lin06121/DCDC_constant_current_power_supply/工程实践与科技创新III-A_第22组李昱林简报.docx

工程实践与科技创新III-A

第_ 22_组工作情况简报

第5周周报

汇报人：李昱林

汇报日期：2026.10.18

# 具体内容：第一周硬件工作 一、本周工作概述本周围绕阻容元件功能通路的设计与测试硬件实验开展全流程工作，完成芯片手册研读、电路参数设计、贴装元件焊接基础练习，以及开关电源核心振荡与PWM调制模块调试，掌握器件选型计算、基础焊接操作与数字示波器高阶使用方法，验证了开关电源PWM占空比自动调节的核心工作原理。

# 二、主要工作内容与成果

### （一）实验预习与电路参数设计

查阅TPS40200芯片数据手册与表面贴装元件规范，完成开关电源核心参数方案设计。掌握芯片基础特性、阻容元件封装与标识规则，明确贴装焊接的工艺参数要求；完成开关频率、软启动时间、输出电压设点、限流保护、滤波网络等关键项的器件选型，确定设计方案。

### （二）元件焊装见习

完成表面贴装阻容元件的焊接基础训练，初步掌握小封装元件对位、上锡、焊点修整技巧，焊点质量符合工艺要求，为完整电路焊装建立工艺基础。

### （三）核心模块调试与测试

分模块开展振荡电路、PWM输出电路功能验证。测试验证了示波器探头阻抗对高频测量的负载效应，总结了输入电压对振荡波形的影响规律；验证了栅极连接状态对PWM波形质量的影响；通过外部注入信号模拟反馈，验证PWM占空比自动调节逻辑。

软件内容 基于 TM4C1294 重构 ADC Demo：以 Timer0A 1 kHz 硬件触发 ADC0 序列并启用 16× 硬件过采样（等效 16 kHz 原始采样率），单序列同步采集 CH0/PE3、CH1/PE2、CH2/PE1 三路信号，保证通道间时间对齐；在采样中断中实现 16 点滑动窗口平均（环形缓冲 + 运行和，O(1) 更新）抑制纹波；SysTick 20 ms 驱动 TM1638 显示、100 ms 刷新电压值，新增 RawToMilliVolts() 整数换算并预留标定接口；新增 uart_debug.c/.h 串口调试模块，UART0 @115200 每 100 ms 输出三路电压与原始码值，提供 Init/String/Line/ADCDump 四个 TX-only 接口，并完成 Keil 工程注册。

第6周周报

汇报人：李昱林

汇报日期：2026/10/25

这周在硬件实验二及第二阶段稳流源电路的 PCB 设计与调试过程中，我们重点围绕 TPS40200 降压/稳流转换器的核心参数、故障排查以及 PCB 布局规范进行了系统性梳理。以下是主要问题与解决方案的总结：

一、 硬件实验二：TPS40200 降压稳压模块调试与问题解决

1. 开关频率 ( f_(SW) ) 的核算与确认
  - 问题：需要确保振荡参数与开关频率的匹配性。
  - 解决方案：根据外接振荡元件参数（如 R_7 =300 kΩ 、 C_9 =1500 pF ），通过标准公式计算并确认系统的标称开关频率设定在 300 kHz 。同时核对了限流滤波电容 C_12 的理论计算边界。
2. 误触发过流保护（OCP）的排查
  - 问题：电路在运行或加载时频繁出现无规律的提前过流保护关断。
  - 解决方案：经排查确认核心原因是 C_11 （VDD 旁路去耦电容）容量偏小。当高侧 MOSFET 导通时引起 VDD 电压瞬时塌陷和高频毛刺，干扰了 ISNS 与 VDD 的过流比较基准。增大并优化 C_11 后成功消除了误触发。
3. 纹波与转换效率的指标优化
  - 现状与方向：当前实测输出纹波约为 60 mV ，转换效率约为 85% 。
  - 解决方案：明确了后续通过选用更低 ESR 的输出电容、降低电感 DCR 以及合理匹配假负载（如静态维持用的 R_23 =200 Ω 降压轻载电阻或满载功率电阻）来进一步压缩纹波和提升效率的路径。

二、 阶段二：稳流源电路 PCB 画板与系统设计

1. 模块功能定位与指标
  - 设计要求：基于 TPS40200 构建直流稳流（Constant Current）模块，主要实现 0.1–1.0 A 可调电流输出 以及 5.25 V 限压保护。
2. PCB 独立构建与系统交互
  - 布局规划：该模块作为独立构建的自定义 PCB（不包含在 MCU 载板 A2000TM4 上），需要与主控 MCU 进行紧密交互。
  - 关键设计要点：
    - 需通过 I²C 接口的 DAC6571 接收外部指令进行电流设定。
    - 需通过 ADC 实时监测输出电压与电流。
    - 在 PCB 画板布线时，必须严格做好功率开关回路（大电流、高频开关节点）与弱电数字通信信号（I²C / ADC 采样线）的地线隔离与去耦，防止高频开关噪声耦合至控制端。

第7周周报 汇报人： 汇报日期： | 具体内容：
第8周周报 汇报人： 汇报日期： | 具体内容：
第9周周报 汇报人： 汇报日期： | 具体内容：
第10周周报 汇报人： 汇报日期： | 具体内容：
第11周周报 汇报人： 汇报日期： | 具体内容：
第12周周报 汇报人： 汇报日期： | 具体内容：
第13周周报 汇报人： 汇报日期： | 具体内容：
第14周周报 汇报人： 汇报日期： | 具体内容：
