lin06121/DCDC_constant_current_power_supply/Pastcode/工程实践与科技创新[3A]-第33组(于前程)设计报告(1).docx

| 班级 | 学号 | 具体负责的工作 | 联系方式
于前程 | F1703401 | 517030910121 | 实验安排，电路设计，电路调试，报告撰写 | 19821244293
韦金星 | F1703401 | 517030910165 | 电路焊装，电路调试，报告撰写 | 15201951656
宋许健 | | | 程序设计，电路调试，报告撰写

摘 要：

本报告为 2019级工程实践与科技创新 3A 第 33组的实验报告，本报告主要介绍了基于 TPS40200 芯片DC-DC 开关电源电路的设计，介绍了单片机MSP430对电源进行监控和均流控制的实现过程。系统可并联输出电压和电流，控制输出电流大小，显示当前输出电压和电流，带输出保护和负载均衡。总体输出表现为稳压电源，直流电压5V，输出额定电流达到2A。

报告从设计思路、电路设计、硬件的工作原理、电路参数的选取、焊接过程、程序设计以及调试结果进行介绍，包含有 MSP430 单片机程序各个模块的功能、系统框图、硬件和软件的实现方法以及最终成果照片。附录为我们小组实验过程中遇到的问题、实验心得以及程序清单。

关键词：

DC-DC开关电源， MSP430单片机，TPS40200，A/D转换，负载均衡

ABSTRACT

This report is the experiment report of the 33rd group of engineering practice and scientific and technological innovation 3a in 2019. This report mainly introduces the design of DC-DC switching power supply circuit based on tps40200 chip, and introduces the realization process of power supply monitoring and current sharing control by MSP430 single chip microcomputer. The system can parallel output voltage and current, control output current, display current output voltage and current, with output protection and load balancing. The overall output is a regulated power supply with a DC voltage of 5V and a rated output current of 2A.

The report introduces the design idea, circuit design, working principle of hardware, selection of circuit parameters, welding process, program design and debugging results, including the function of each module of MSP430 single chip computer program, system block diagram, realization method of hardware and software and photos of the final results. The appendix shows the problems, experience and program list of our group in the process of experiment.

KEYWORDS

DC-DC switching power supply, MSP430 single chip microcomputer, tps40200, A/ D conversion, load balancing

目 录

2.2.3 单片机控制模块...........................................................................................4

3.5 关键问题与解决方案.......................................................................................11

# 1. 概述

## 1.1 编写说明

本报告为2019~2020学年上海交通大学电子系工程实践与科技创新3A第33小组的课程设计报告。本报告详细介绍了基于开关稳压稳流并联电源的硬件电路设计，单片机软件开发流程，程序设计思想，测试方法，测试指标与结果以及实验中遇到的各种问题和解决方法。分别介绍了稳压源、稳流源及并联系统的设计与实现过程。同时也表达了我们实验的心得体会，以供后续的实验者参考。

本报告的适读对象为选修 3A 课程的学生及电子电路相关专业人士以及有一定基础的业余电子设计爱好者。编写过程中错误疏漏在所难免，希望各位读者批评指正。

## 1.2 名词定义

开关式稳压电源：采用开关三极管控制的直流稳压电源，可通过占空比的调节控制电压输出。（本实验中使用TL2371输出的PWM波控制开关占空比。）

降压型DC-DC开关电源：通过芯片控制实现高电流电输入转化为低电流电输出的系统。（直流到直流的降压变换。）

均流控制：双并联的电路在稳压输出的情况下调整电流输出，使得各个电源的输出电流相等。

纹波：纹波是由于直流稳定电源的电压波动而造成的一种现象，因为直流稳定电源一般是由交流电源经整流稳压等环节而形成的，这就不可避免地在直流稳定量中多少带有一些交流成份，这种叠加在直流稳定量上的交流分量就称之为纹波。

PWM 信号：脉冲宽度调制信号。脉冲信号的占空比受到调制的一种信号。

占空比：在一串理想的脉冲序列中，正脉冲的持续时间与脉冲周期的比值。
开环控制[1]：控制装置与被控对象之间只有顺向作用而没有反向联系的控制。
闭环控制[2]：对系统的输出进行测量，并将它反馈至输入端与输入（预期的输出）进行比较（相减），利用其误差信号对系统进行控制。
数模转换[3]：为把数字信号转换为信息基本相同的模拟信号而设计的处理过程。
模数转换[4]：为把模拟信号转换为信息基本相同的数字信号而设计的处理过程。
开关频率：开关电源中，开关管导通，关闭的频率。
电压调整率[5]:用来描述输入电源电压的变化导致的开关稳压源输出电压发生的微小变化的指标。
负载调整率[5]:用以衡量负载改变时开关稳压源输出电压的变化的指标。
负载均衡度：用以描述供电系统电流均流的程度的指标。

脉冲宽度调制：一种对模拟信号电平进行数字编码的方法。通过高分辨率计数器的使用，方波的占空比被调制用来对一个具体模拟信号的电平进行编码。

## 1.3 硬件开发环境

开发工具 | 功能 | 工作环境
直流稳压源 | 提供10~20V稳定输入电源 | 220V交流电
万用表 | 测量电压、电容、电阻数值 | 220V交流电
示波器 | 测量纹波 | 220V交流电
电烙铁，焊锡，镊子，钳子 | 焊接电路 | 220V交流电/实验台

表1 硬件开发环境

## 1.4 软件开发环境

开发工具 | 功能说明 | 运行环境
CCS(Code Composer Studio) | 单片机集成开发 | Window 10

## 表2 软件开发环境

## 1.5 缩略语

DC： direct current 直流
PWM： Pulse-Width Modulation 脉宽宽度调制
ADC： analog digital convert 模拟-数字转换

DAC： digital analog convert 数字-模拟转换

CCS ： code composer studio 一种集成开发环境

LPF ： low-pass filter 低通滤波器

# 2. 系统总述

## 2.1 系统组成[6]

基于TPS40200的

DC-DC开关稳压电源

+

−

10-20V

io1

负载

电流检测

+

−

5V

基于TPS40200的

DC-DC开关稳流电源

电流检测

+

−

电流设点

io2

控制部件

ADC1

电流测量

ADC3

电压测量

MSP430

单片机系统

DAC6571

I2C

ADC2

电流测量

图 1 系统总框图

系统总框图如上，需要搭建一个稳压电源模块、稳流电源模块并联输出，单片机实施均流控制的并联供电系统。总体输出表现为稳压电源，直流电压5V，输出额定电流达到2A。

## 2.2 系统的主要功能

DC-DC开关稳压源输入电压10-20V，输出电压5V，额定电流1A，有过流保护；在稳压源基础上改装DC-DC开关稳流源，输出电流0.1-1A，带过流保护和限压保护，使用MSP430单片机编程控制DAC6571，设置输出电流；稳压源模块和稳流源模块分别可以独立工作。当这两个模块联合后并联输出，整体成为一个稳压电源系统，可以提供更大的输出功率。并联工作时，稳压源模块作为主（控制）模块，稳流源模块作为从（受控）模块，输出电流跟随主模块输出电流的变化而变化，利用单片机检测两路输出电流，均衡后输出。

### 2.2.1 DC-DC 开关稳压电源模块

#### 2.2.1.1 稳压输出

DC-DC 开关式稳压电源模块基于TPS40200，可适配直流输入电压10-20V ，输出端在不同负载的情况下（包括空载）直流输出电压稳定在为5V 左右。同时具有较高电源转换效率和较小输出纹波。

#### 2.2.1.2过流保护

为了避免电路中的较大电流会对电路元器件造成损伤，电路设有过流保护功。当输出电流大于设定的阈值时，电路自动关断，输出电流和输出电压均为0。

#### 2.2.1.3电压电流监测

电流采样传感信号通过差分放大电路模块检测电流，电压值，并将其显示在单片机上。

### 2.2.2 DC-DC 开关稳流电源模块

#### 2.2.2.1稳流输出

DC-DC开关式稳流电源模块基于TPS40200，可适配直流输入电压10-20V，其直流输出电流稳定在一个设定值，该设定值可在指定范围内选择设置。

#### 2.2.2.2 限压保护

为了避免接较大负载或者空载时，电路中的大电压对电路元器件造成损伤，电路增加了限压保护功能。当输出电压大于设定的阈值时，电路将自动调整输出电压到正常的值。

#### 2.2.2.3 电压电流监测

电流采样传感信号通过差分放大电路模块检测电流，电压值，并将其显示在单片机上。

2.2.3单片机MSP430小系统精密均流调整模块

该模块在稳压源和稳流源并联工作时使用，使用MSP430 单片机控制 DC-DC 开关电源均流。单片机通过内置 ADC 监测两路电源模块的输出电流，利用DAC芯片 DAC7611 输出控制信号，控制稳流源输出电流。单片机调用上述 ADC 及 DAC，并使用控制算法构建出完整测控系统，最终实现控制电流源的输出电流，使得并联系统稳压源稳流源电流相等，即实现稳压源与稳流源的负载均衡的功能。

# 3. DC-DC开关稳压电源模块的设计和实现

## 3.1 主要功能与设计指标

### 3.1.1 主要功能

该模块的核心器件是TPS40200，能在直流输入电压10-20V 下稳定输出直流电压5V 。模块内部包含输出电流采样传感部件，可以完成限流保护功能。该模块要兼顾负载调整率、电压调整率、电源转换效率与输出电压纹波幅度，同时通过单片机和放大采样电路实现输出电压和输出电流的监控和显示功能。

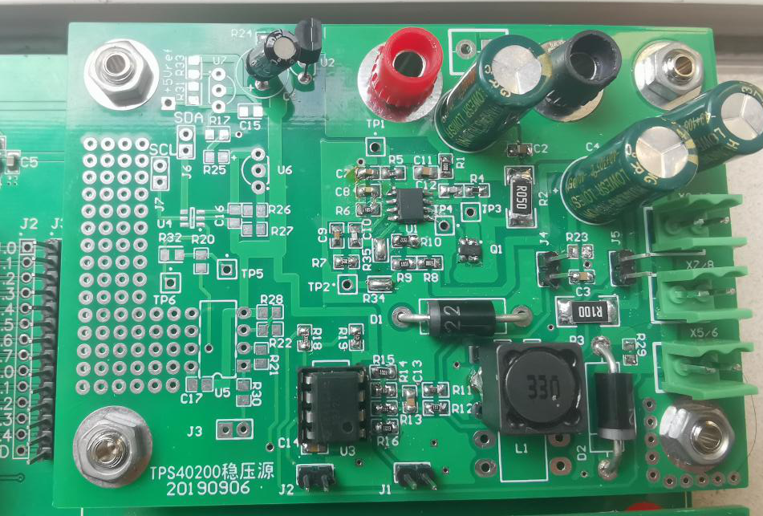
[picture p1: figure]

图2 DC-DC开关稳压电源模块焊接成品

### 3.1.2 设计指标

具体设计指标及最终参数选择如下表所示。

设计要求 | 设计指标 | 元件参数
外围RC定时电路 | 振荡频率取300KHz左右 | R5 = 68kΩ C7 = 470pF
设置软启动定时 | 不小于50ms | C8 = 10 uF
设置输出电压 | 按要求5V | R10 = 16kΩ
设置过流保护 | 输出过流保护触发值允许范围： 1.1A~1.9A | R4 = 2k C12 = 200pF
输出电流检测信号 | 放大10倍 | R15=R16=100kΩ R13=R14=10kΩ
输出电压信号调理 | 二分之一衰减 | R18=R19=10KΩ

表3 DC-DC开关稳压电源模块设计指标[¹]

## 3.2 电路设计原理

### 3.2.1 核心器件TPS40200

TPS40200为宽输入非同步降压DC/DC控制器芯片，TPS40200的原理图[7]如下所示：

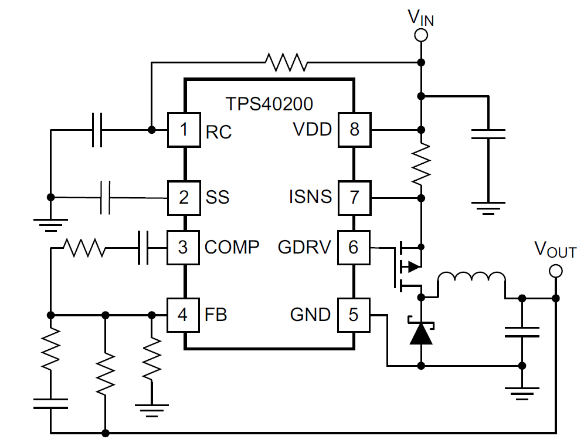
[picture p2: figure]

图3 TPS40200原理图

TPS40200功能框图[7]如下所示：

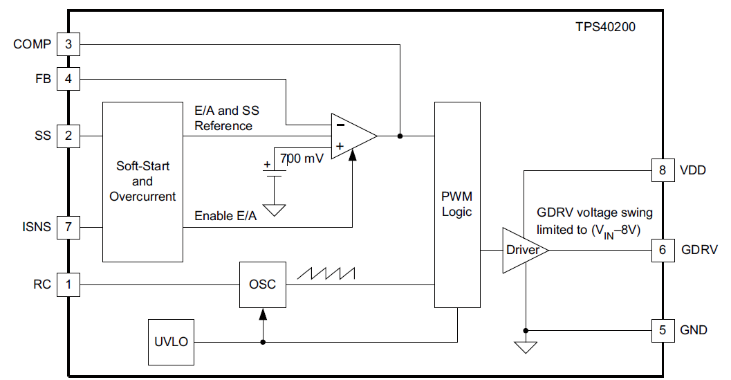
[picture p3: figure]

图4 TPS40200芯片结构图

芯片管脚和对应功能[7]：

输入电压和欠压保护 UVLO（8号脚） 一般工作在4.5V以上电压，输入电压范围4.5V–52V。大于UVLO门限4.25V 以上就可工作。当大于 UVLO 门限时，芯片启动，转换开始，软启动电路使能。TPS40200将以接在软启动引脚（SS）上的外部电容（软启动电容）决定的速率提高输出电压。欠压保护机制可以确保仅当输入电源电压已经超过正常工作所需最小电压时，芯片才正确启动。

软启动（2号脚） 软启动作用于变换器控制电路，通过逐渐增加脉冲占空比实现。通过软启动控制电路，可以使变换器从零启动，减小电流浪涌带来的浪涌电流应力，提升系统的稳定性。同时，在过流保护情况下会根据软启动定时进行打嗝重启（反复重启），在检测到过流条件消失后恢复系统的输出。

PWM信号输出与输出电压（6号/4号脚）GDRV脚（6号管脚）会输出脉宽调制PWM信号，该信号控制开关管的连通和关断，以此来控制输出电压的高低。而输出电压通过反馈电路经过分压反馈给FB脚（4号管脚），与内部基准电压696mV通过误差放大电路进行比较，对PWM进行调控，调整输出电压。具体调节的方式如图4所示。通过这一反馈调节，可以形成动态平衡，最终使输出电压稳定某一设定值。

锯齿波生成（1号脚）：通过外部连接一个RC电路，可以设置TPS40200的工作频率。外部的RC电路与TPS40200内部的电路形成一个锯齿波生成电路，TPS40200将以此频率生成锯齿波，该锯齿波可以在RC脚（1号管脚）检测到。

过流保护（7号/8号脚）：检测VDD脚（8号管脚）与ISNS脚（7号管脚）的压降，若存在100mV以上压降，则达成过流条件，输出的PWM波持续处于高电平，使开关管关断，使输出电压降为0V，保护电路和负载

### 3.2.2设计原理

本模块电路分为以下几个模块构成：外围RC定时电路部分、软启动定时部分、电压控制部分、电压输出部分、过流保护部分、辅助电源部分、电压电流检测部分。

大部分元件参数在电路图中已经给出，少部分元件的参数需要通过自己的计算推导进行设计。整体电路图[8]如下图所示：

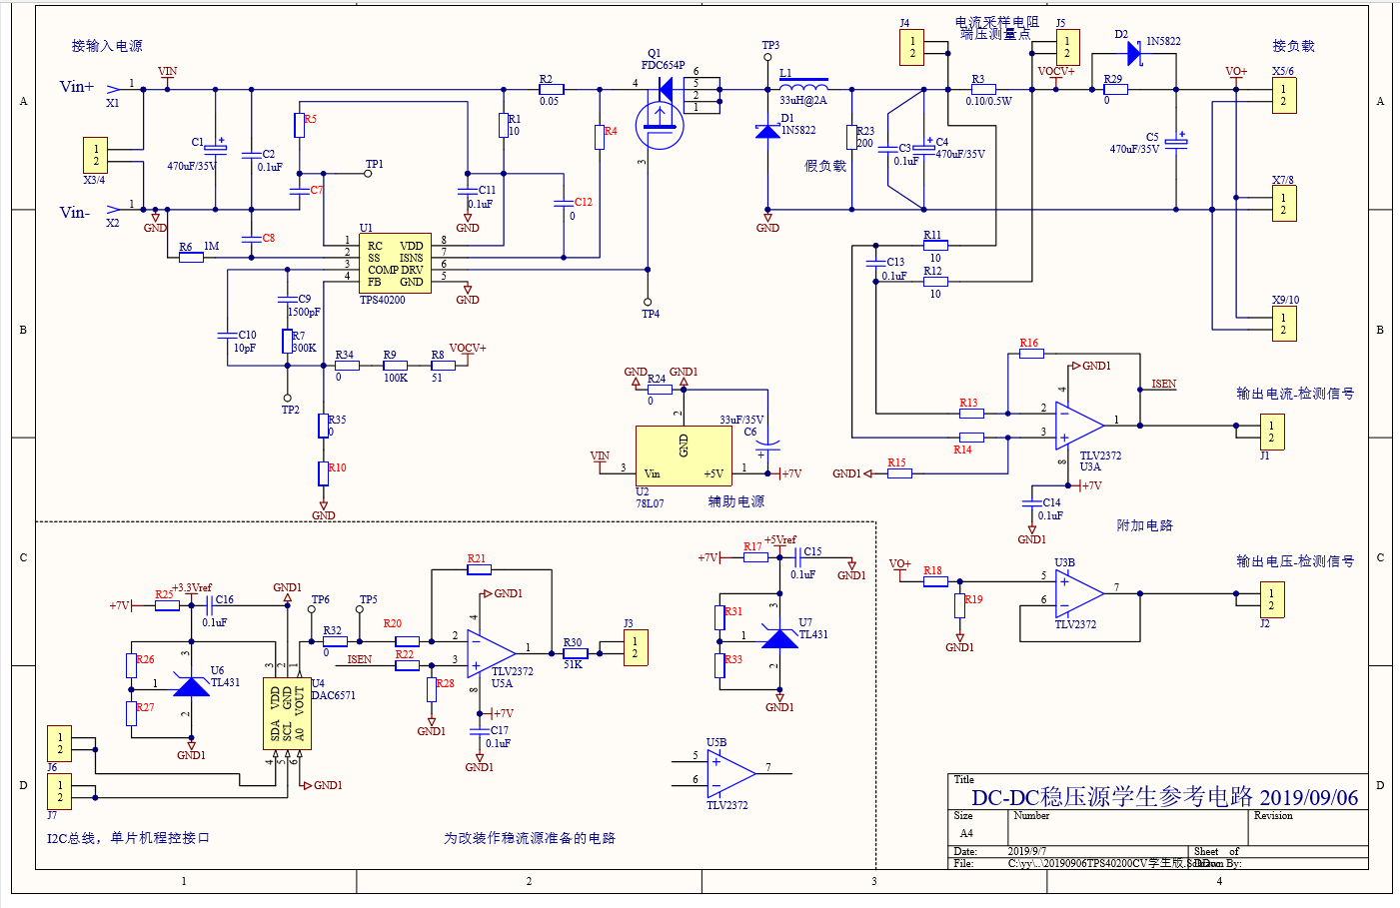
[picture p4: figure]
捕获

图5 DC-DC开关稳压电源模块电路图

## 3.3 电路各部分设计与元件参数说明

### 3.3.1 外围RC定时电路部分设计

本模块中TPS40200工作频率是由和控制。振荡器频率计算公式如公式(1)所示，振荡频率按要求取300kHz。同时，应足够大，使得通过的电流不超过750μA，如公式(2)所示。

(1)

（2）

所以最终选取以及，此时。

经过调试，该参数能使TPS40200工作正常。

### 3.3.2 软启动定时部分设计

上面的介绍中已经知道本模块中软启动定时的设定由控制。根据芯片手册中的公式(3)，由于软启动定时，且、、，代入可得到结果。

(3)

所以我们选取了10μF的电容，经过调试，该参数能使TPS40200工作正常。

### 3.3.3 输出电压部分设计

输出电压的设定涉及到电压反馈，主要由由、和组成。这三个电阻组成了一个分压电路，由于TPS40200的FB脚（4号管脚）在稳态是恒定的696mV，且输出VOCV+是所设定的5.00V，根据公式(4)，R2=（100K+51）Ω，可以得到。

（4）

经过调试，取时，输出电压满足相应的指标要求。

### 3.3.4 过流保护部分设计

过流检测阈值由元件R4，C12决定，要求输出过流保护触发值允许范围为1.1A~1.9A

相关的电路原理图[7]如下所示：

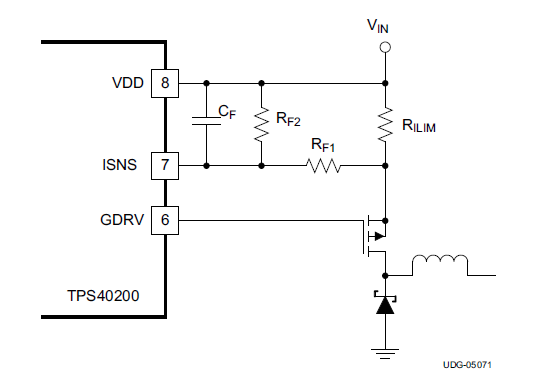
[picture p5: figure]

图 6 过流保护检测模块

参照软件手册计算得R4=2kΩ，C12<400pF，取200pF。经电路调试后发现选择该参数可以实现过流保护。

### 3.3.5 电压电流检测部分设计

### 本模块中，、、和与运算放大器TLV2372构成一个差分放大电路，用以监测输出电流。我们可以通过测量的电流采样电阻的电压来获得实际输出电流。考虑到单片机ADC的精度和电压承受范围以及TLV2372的驱动电压，我们采用10倍放大对电流采样电阻两端的电压进行放大。根据公式(5)，选取R13 = R14 = 10kΩ，R15 = R16 = 100kΩ。

（5）

和与运算放大器TLV2372构成一个电压跟随器，用以监测输出电压。考虑到单片机ADC的精度和电压承受范围以及TLV2372的驱动电压，我们将输出电压分压成一半。即选取R18 = R19 = 10kΩ。

经实体电路测试，上述取值均符合设计指标。

## 3.4 输出电压与输出电流监测的实现

本模块中输出电压与输出电流的检测由单片机内部ADC10模块来实现。可将硬件电路部分的监测点用杜邦线连接到单片机引脚上，在第一阶段中，用于测量电流的J1连接单片机P1.0引脚，用于测量电压的J2连接单片机P1.1引脚。ADC采用单通道单次采样，其模式设置可参考msp430x2xxx family 单片机 user guide.pdf。系统实现的流程图如下：

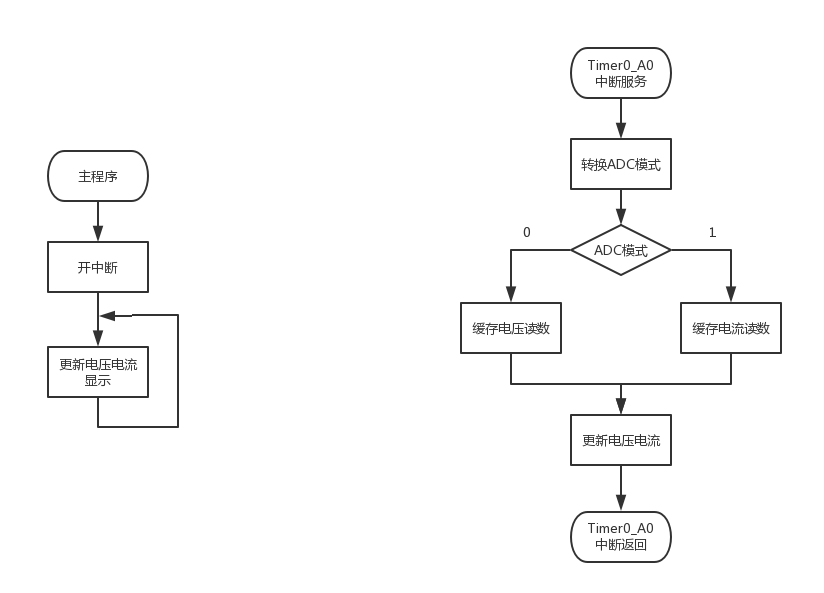
[picture p6: figure]

图 7 单片机代码实现流程图[9]

为了消除随机电噪声带来的读数波动，可对多次采样的结果取平均值。实际调试结果表明当取上千次平均时测量值可以保持很稳定。受制于单片机的内存大小，无法把全部数据都储存在数组中，因此我们在第一阶段使用单通道时分切换采样两路电信号，将电压电流信号采样数据缓存在两个较大的数组中，每采样一次就对缓冲区的所有点做平均求出此刻的电压电流量，这样做虽然消耗空间很大，但是非常灵敏，已经满足本阶段的要求。

得到ADC多次采样的结果，再乘以相应系数，即可得到对电压或电流量的初步估计，但是此时很可能误差不满足指标。为了提高测量精度，可设置一个线性公式拟合消除可能的偏差。其基本思想是，测出若干组实测值X（电流采样电阻端压或负载端压）和显示值Y（单片机示数），拟合出一个线性关系 Y = kX+b，对原系数进行修正，即可得使得显示值得比较接近实测值。拟合的过程将在5.4.2节举例阐述。

## 3.5 关键问题与解决方案

### 3.5.1纹波调整[5]

输出电压纹波主要有两个来源：

（1） 开关交替充放电因素，波形成分表现为三角波形，如下图中的蓝色部分。
（2） 开关切换瞬间的电磁涡流感应因素，波形成分表现为尖刺波形，如下图中的橙色部分。

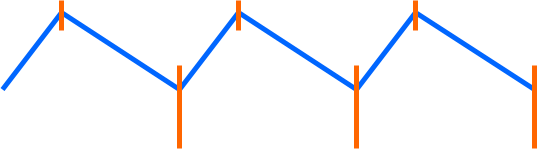
[picture p7: figure]

图 8 输出电压纹波示意图[5]

我们小组一开始测量纹波的时候波形很不稳定，峰峰值时大时小。后来发现是示波器探头与电路接触不好导致的，后来更换示波器探头使之与导线完全接触，这样波形就能够稳定下来。调试电路时得到的纹波较小，符合标准，我们小组就没有对电路进行改进。

### 3.5.1 效率调整[5]

可以通过增大假负载来提高电源效率。该措施可以减小空载时假负载上的电流，可以一定程度上提高效率，开始时转换效率只有86%左右，这个是比较低的，所以我们小组最后拆去了假负载，最后几次调试电路时电压转换效率基本在90%左右，虽然这么做对纹波有一定的影响，但还好影响不大。

### 3.5.2 单片机显示精度调整[1][10]

单片机显示精度的调整通常有四个措施：

（1） 做好ADC前置调理电路的性能，即精选电阻，减小前置差分放大电路元件值实际误差
（2） 通过软件逻辑设计补偿显示误差，即使用线性公式或使用查表法对显示结果进行精调
（3） 通过软件滑动窗口平均算法增加显示数值稳定性，单片机软件设计上增加抗噪声措施，即多次采样取平均，相当于低通滤波的效果，减小瞬时随机噪声影响
（4） 软件逻辑中使用阻滞门限增加显示数值稳定性

# 4. DC-DC开关稳流电源模块的设计和实现

## 4.1 主要功能和设计指标

### 4.1.1 主要功能

DC-DC开关稳流电源模块在DC-DC稳压源模块的基础上进行改进，在实现单片机检测输出电压和电流的情况下，还能设定电流源输出电流值，主要功能如下：

（1） 实现稳流源的限压在5V左右
（2） 单片机指定稳流源输出电流值
（3） 单片机监测稳流源输出电压和电流值
（4） 在输入电压为10±0.1V和负载电阻合理的情况下，输出指定电流，输出电压和负载值呈 线性关系，若负载不符合条件则将触发限压保护。

### 4.1.2 设计指标

检测项目 | 检测条件 | 检测指标
输出电流绝对精度 | 输入10.0V±0.1V； 设定输出电流0.1、0.2或0.3A Rload=5.1Ω或10Ω | 围绕精确数值±0.5mV以内波动
| 输入10.0V±0.1V； 设定输出电流0.8A Rload=3Ω或5.1Ω | 78.0~82.0mV波动
输出限压保护和恢复 | 输入电压10.0V±0.1V；设定输出电流1.0A | 限压输出5.0~5.4V，且更换负载电阻后输出电流恢复正常。
单片机监测电压和电流 | 输入10.0V±0.1V；任选一种输出≥0.5A的工作状态进行检测 | 输出电压误差小于等于0.02V
| | 输出电流误差小于等于0.01A

表 4 DC-DC开关稳流电源设计指标[11]

## 4.2 电路原理

### 4.2.1 电路整体原理

DC-DC 开关稳流源的整体电路设计基于DC-DC开关稳压源的设计原理图改造而来，大部分与稳压源设计类似，在此不多做阐述，仅描述稳流功能的实现。DC-DC 开关稳流源在稳压源的基础上，添加误差放大电路，确定电流误差后，以DAC6571 为核心控制器件，单片机通过I2C程控DAC6571的输出，作为设定的电流值；该电流值再通过差分放大电路开环控制稳流源电流的实际输出， 稳流源改装方案[12]如下图所示：

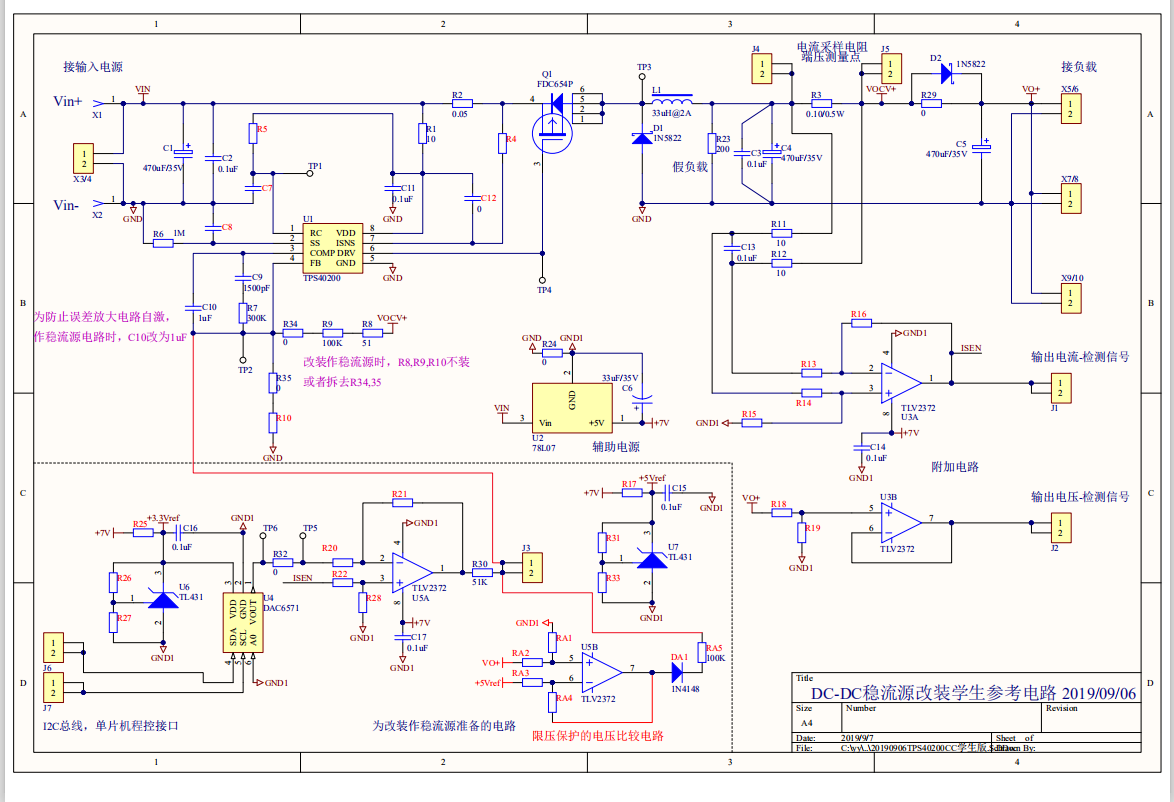
[picture p8: figure]
捕获

图9 稳流源改装参考方案

其具体工作原理如下图所示：

基于TPS40200的

DC-DC开关稳流电源

+

−

10-20V

io2

负载

电流检测

+

−

0.1A~1A

控制部件

ADC1

电流测量

ADC2

电压测量

MSP430

单片机系统

DAC6571

电流设点

I2C

图10 稳流源设计原理[6]

### 4.2.2 误差放大电路

误差放大电路的作用是比较差分放大电路两路信号，确定电流误差。如下图所示，ISEN是对输出电流做检测得到的信号，TP5是对输出电流设点的控制信号，选取,则差分放大电路的输出为实际电流值 ISEN与设定电流值之差的10倍，即J3 = 10 * (ISEN - TP5)。

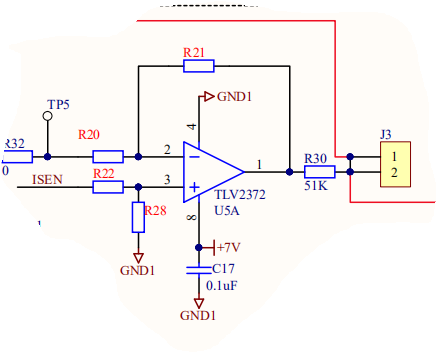
[picture p9: figure]
捕获

图11 误差放大电路[12]

差分放大电路的输出值J3作为TPS40200芯片内部的的差分放大器的输入，与0.696V进行比较。如果J3大于0.696V时，TPS40200的输出电压VO+将减小，因此电路的实际输出电流ISEN将减小，知道J3输出值无限逼近0.696V。这时可认为实际输出电流ISEN与TP5设定电流值大致相等，达到稳流效果。

所以在本次实验中，差分放大器我们选择放大倍数为10倍，最后选定，。

### 4.2.3 DAC6571程控输出电流的控制

DAC6571芯片管脚图和管脚描述分别由下面的图12和表5所示，外围RC电路提供3号管脚所需的+5V输入电压，2号管脚接地，芯片正常工作。

图12 DAC6571芯片管脚图[3]

管脚 | 名称 | 描述
1 | VOUT | DAC输出电压
2 | GND | 接地点
3 | VDD | 输入电压
4 | SDA | 串行数据输入
5 | SCL | 串行时钟输入
6 | A0 | 设备地址选择

表5 芯片管脚描述[3]

下图为单片机控制DAC6571的电路图部分：

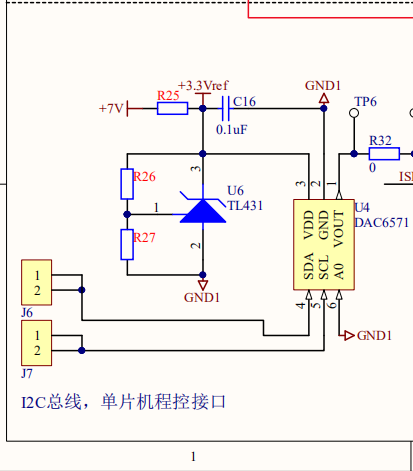
[picture p10: figure]
捕获

图13 单片机控制DAC6571电路图[12]

如上图所示，管脚4的串行数据输入信号和管脚5的串行时钟输入信号作为DAC6571芯片的I2C接口与单片机进行通信。单片机在串行时钟信号的控制下，将电流数据作为串行输入数据输入到DAC6571芯片内部，从而芯片1号管脚输出相应电压，从而产生输出电流。单片机编程控制接口是I2C总线标准的，用GPIO模拟I2C。

由于需要键盘输入来设定输出电流值，从而要在程序代码中设置中断，定时检测键盘输入值，再根据键盘的输入值调整电流值，最后传给芯片。

单片机控制DAC6571芯片的流程图[9]如下图所示：

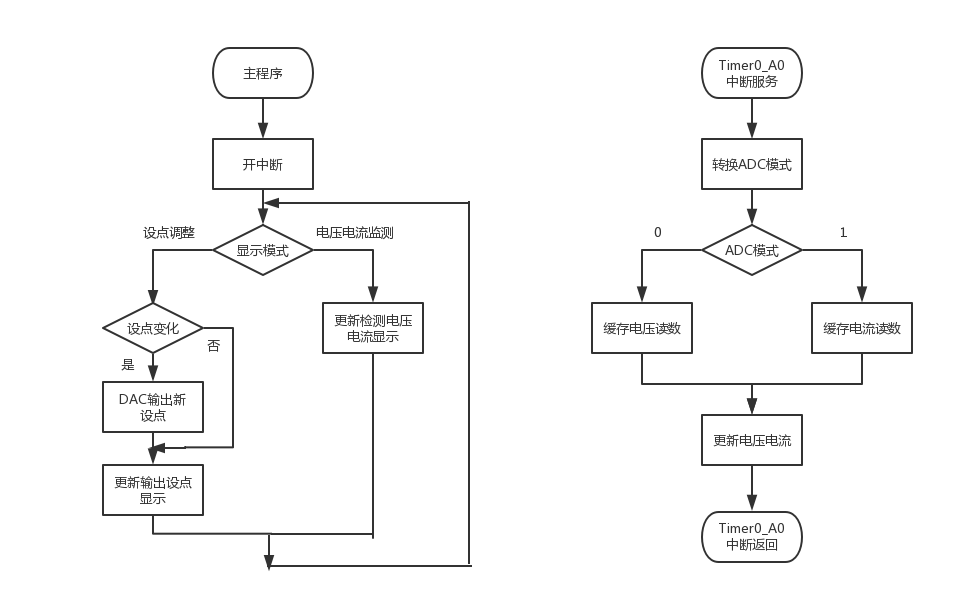
[picture p11: figure]
88642791b83076162f312944fe5e630

图14 单片机稳流电路控制流程图

为了方便测试需要和校对结果，本系统采用了两种步长的电流调整方式，对应按键的具体功能如下表所示：

按键 | 功能
S1 | 电流+0.01A
S2 | 电流-0.01A
S3 | 电流+0.1A
S4 | 电流-0.1A

表6 稳流源模块按键功能描述

DAC6571芯片3号管脚的输入电压VDD运用TL431产生，电路图如下图所示：

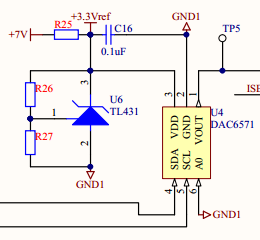
[picture p12: figure]
DAC电压提供

图15 TL431基准电压产生电路图[12]

基准电源电路主要由一个稳压二极管TL431组成。TL431稳定电压计算公式[3]：

V_(out) = (R_26 +R_27)/(R_27)V_(ref)

其中为TL341内部基准电压，为2.5V。为保证输出电压，选取，

由于，规定满足，又为了保证稳压管正常工作，所以选取

### 4.2.4 限压保护电路

电压比较(差分放大)如下图电路所示，其中VO+为输出电压采样。由于二极管DA1的存在，使该部分电路的输出在常态下对ErrAmp无影响；而发生限压作用时，其输出对稳流放大造成压制。当实际输出电压VO+大于5V时，运算放大器U5B的输出为正，从而使二极管DA1导通，从而使得J3的输出增加。与上述稳流原理一致，当J3的输出增加，芯片TPS40200调节输出VO+，VO+减小，直至VO+小于5V，运算放大器U5B输出为负，从而二极管DA1截止，J3输出不受影响。

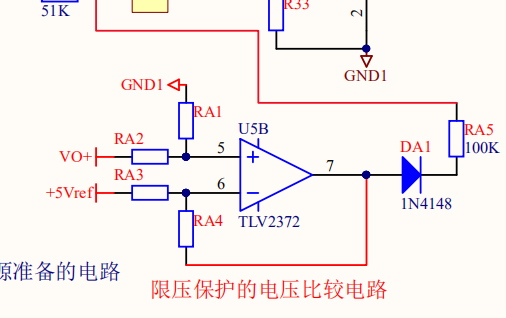
[picture p13: figure]
捕获

图16 限压保护电路[12]

要求差分放大电路放大倍数同样为10倍，所以本次实验中，选定，。

其中提供基准的+5V参考电压运用TL431产生，相关电路图如下所示：

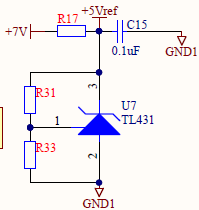
[picture p14: figure]

图 17 TL431基准电压产生电路[12]

基准电源电路主要由一个稳压二极管TL431组成。TL431稳定电压计算公式[3]：

其中为TL341内部基准电压，为2.5V。为保证，选取，为保证稳压管正常工作，选取较小的值，从而选取。

# 5. 双模块并联输出及负载均衡

## 5.1 主要功能与设计指标

### 5.1.1 主要功能

双模块并联输出的主要功能：输入10~20V的直流电压，通过反馈并联输出约5V的直流电压，输出额定电流达到2A，两模块输出电流基本相同。该模块要兼顾负载均衡误差与电压波动。同时通过单片机和采样电路实现输出电压和两模块输出电流的监控功能。

### 5.1.2 设计指标

具体设计指标如下表所示。

检测项目 | 检测条件 | 数值要求
负载均衡度 | 输入10.0V±0.1V； Rload=5.1Ω//10Ω | 并联输出电压须稳定在4.85~5.15V，负载均衡误差小于等于2%，且两路电阻端压各自波动均小于等于2mV
| 不下电更换 Rload=5.1Ω//5.1Ω | 并联输出电压须稳定在4.85~5.15V，负载均衡误差小于等于2%，且两路电阻端压各自波动均小于等于2mV，
单片机监测电压和电流 | 输入10.0V±0.1V；（输出总电流大于0.8A）进行检测 | 误差小于等于0.02V，
| | 误差小于等于0.01A，
| | 误差小于等于0.01A，

表7 双模块并联输出设计指标[¹¹]

## 5.2 电路设计原理

### 5.2.1 电路结构图[6]

综合前两个阶段的成果，搭建一个稳压电源模块、稳流电源模块并联输出，单片机实施均流控制的并联供电系统。总体输出表现为稳压电源，直流电压5V，输出额定电流达到2A。其相关结构图如下 ：

基于TPS40200的

DC-DC开关稳压电源

+

−

10-20V

io1

负载

电流检测

+

−

5V

基于TPS40200的

DC-DC开关稳流电源

电流检测

+

−

电流设点

io2

控制部件

ADC1

电流测量

ADC3

电压测量

MSP430

单片机系统

DAC6571

I2C

ADC2

电流测量

图18 双模块并联输出结构图[6]

### 5.2.2 电路改装

需要对原来的稳压源电路板进行少许改装：

（1） R29不装，加装D2，二极管防止并联后外部电流倒灌

（2）调整R10取值，即用16的电阻代替原来的15，目的是将输出电压设点抬高至5.3~5.4V，弥补通过上述二极管的压降损失

图19 改装电路示意图[12]

## 5.3信号检测测及程控策略设计

单片机仅能控制稳流电路板的输出电流设点，单片机通过ADC可获得三路检测信号，稳压电路板的输出电流、稳流电路板的输出电流、两者并联输出电压。这些信号均可能存在随机电噪声，需适度做连续多次采样的滑动平均。

每次发出新的控制命令，到检测获知被控系统的有效响应，会有一段ms级时延。控制节奏不能太快，建议取0.05~0.1s一次的控制节奏。控制达成动态均流稳定的过程不能太慢，负载突变后一般要在4秒内达成。开机或负载突变，可能造成稳压电路板发生短时过流自保护，关断输出；若控制策略不当，可能发生“跷跷板”现象，系统无法进入正常工作状态。

整体工作流程如下图所示：

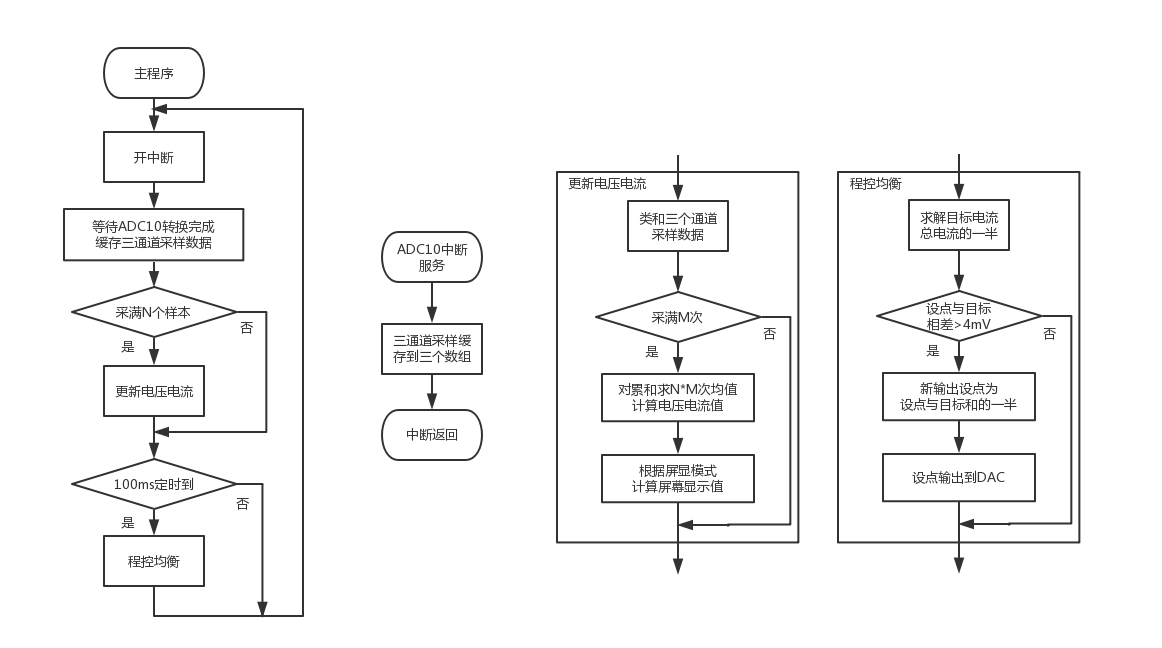
[picture p15: figure]

图20 双模块并联输出程序流程图[9]

### 5.3.1电压与电流监测及显示部分设计

本模块中并联输出电压与两路输出电流的检测由单片机内部ADC10模块来实现。可将硬件电路部分的监测点用杜邦线连接到单片机引脚上，在第三阶段中，用于测量电压的J2连接单片机P1.0引脚，用于测量稳流源电流的J1连接单片机P1.1引脚，用于测量稳压源电流的J1连接单片机P1.2引脚。

为了消除随机电噪声带来的读数波动，可对多次采样的结果取平均值。实际调试结果表明当取上千次平均时测量值可以保持很稳定。受制于单片机的内存大小，无法把全部数据都储存在数组中，因此大概有以下两种解决方案。在第一第二阶段的测量中，我们使用单通道时分切换测量，直接将采样数据缓存在一个较大数组中，每采样一次就对缓冲区的100点做平均求出此刻的电压电流量，这样虽然非常灵敏但是消耗空间很大，无法直接扩展到第三阶段的三个量的测量。另一种解决方案是选择计算量较大的算法以减小空间复杂度，即直接储存N次平均值mean，然后每采样一次采样值v，就利用公式mean’ = (mean*(N-1)+v)/N 来更新平均值，但是其固有特点是反应迟钝，当采样值迅速变化时，需要2N次采样才能估计到正常数值。

我们最终选择了一种折衷方案，此处我们使用三通道同时采样，大小32的缓冲区和200的平均步长，每次求得的是6400点的平均值，既兼顾了更新速度，也平均了读数波动。实现时，三通道采样的数据分别储存在三个采样数组sample_v, sample_i1, sample_i2中，在主循环中，每次采样满32个点就进行累和，每累和200次就更新估计的电压电流值。

在实验中，为了节省计算量，我们在累和ADC采样量时全部使用整数，在计算对应的电压和电流时，乘以相应系数，并利用线性拟合的方式消除部分电路上的偏差。关于拟合的方法将在5.4.2节叙述。拟合以后，即可获得比较精确的电信号估计值。

显示时，由于需要显示三个量，因此我们设置5键来切换显示。第一屏显示稳压源电流和稳流源电流，第二屏显示并联电压。

### 5.3.2均衡调节程控策略设计[9]

本模块中单片机已经可以获得三路检测信号，通过控制稳流电路板的输出电流设点来达到负载均衡。在第三阶段中，用于控制设点电流的SDA连接单片机P1.４引脚，SCL连接单片机P1.５引脚。

负载均衡算法的难点在于其精确性和稳定性。因为每次发出新的控制命令，到检测获知被控系统的有效响应，至少要有一段ms级时延，所以控制节奏不能太快，此处我们取0.1s一次的控制节奏。在实现时，我们已经可以检测稳流源电流CCurrent，稳压源电流VCurrent，并且可以比较精确的控制输出设点output_current与CCurrent保持相同。对于每次检测到的CCurrent和VCurrent两值，我们的目标是使得最终两值相等，在总输出电流CCurrent+VCurrent基本不变的前提下，如果将CCurrent设为当前总电流的一半（均衡电流mid），即则可以快速的达到目标。当然，为了电路的稳定性，我们在控制时将设点电流设为mid和output_current的中值，这样可以减缓电流的变化。如果电路已经稳定，即output_current和mid相差小于某一门限，则不再发送控制信号，这样可以抵御电流值的微小波动。实际测试时，数值一般可以在两到三秒内稳定下来。

开机或负载突变，可能造成稳压电路板发生短时过流自保护，关断输出。因此可以设置初始设点电流为一较大值，如0.8A，则可以有效避免此种情况。

## 5.4关键问题与解决方案

算法设计结束后，需要一定的技巧来调试可能存在的问题。为了满足指标，控制算法还需满足精确和稳定的特点，下面将介绍我们在第三阶段的调试技巧和解决方案。

### 5.4.1算法的调试技巧[13]

（1）暂不将两模块并联，两模块分别接各自的独立负载，单片机检测稳压源的输出电流，以此信息来确定稳流源的输出设点，实现单片机程控稳流源输出电流，跟随稳压源输出电流变化的功能。

（2）两模块并联后，单片机增加检测稳流源的输出电流，并闭环控制稳流源电流设点，减小两模块电流的动态误差。

### 5.4.2算法的精确性[9]

对ADC多次采样量乘以相应系数，即可得到对电压或电流量的初步估计，但是此时很可能误差不满足指标，我们可以利用线性拟合的方式消除部分电路上的偏差。线性拟合的基本思想是，测出若干组实测值X（电流采样电阻端压或负载端压）和显示值Y（单片机示数），拟合出一个线性关系 Y = kX+b，对原系数进行修正，即可得使得显示值得比较接近实测值。

在拟合时，需要较为均匀的取值，直接使用负载较难达到此目标，我们借用了别组的单片机，使用我们第二阶段的代码来生成特定的电流控制信号，如0.1-1.2A，再接到我们的SDA和SCL接口上，即可设置比较均匀的电流设点。如图，上一块单片机为“外援”。

接入“外援”单片机后，设点使得电压均匀变化，获得如下结果：

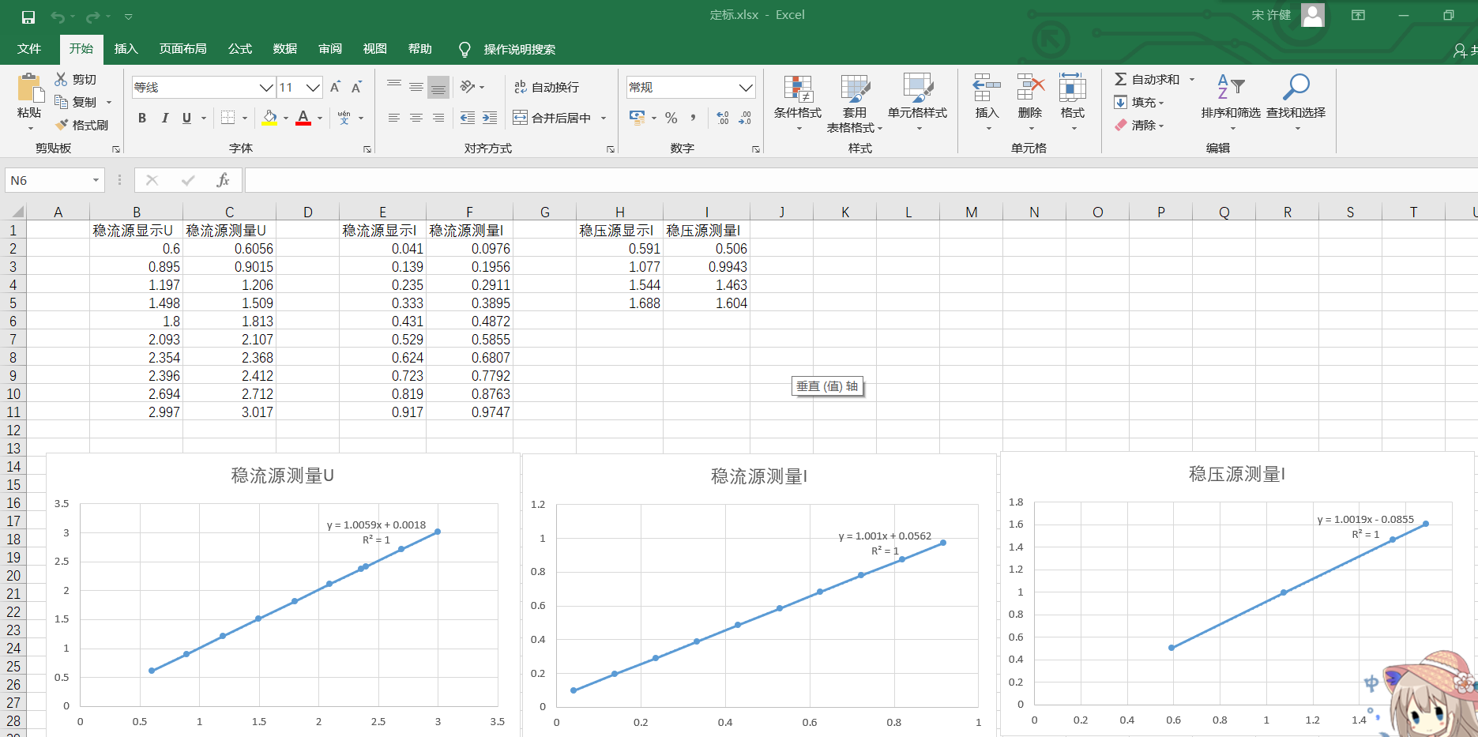
[picture p16: figure]

图21 线性拟合结果

以稳流源显示结果为例，拟合结果为y = 1.0059x + 0.0018，原关系式为：Volt = 6.9509*v_sum/n_sample/N_avg+3.652，则修正后Volt = 6.9919*v_sum/n_sample/N_avg+3.6753。

稳流源的电流示数可依此法。稳压源的电流需要两模块并联后，控制电流源输出电流从而为电压源输出电流设点。稳流源设点电流值与实测电流值在拟合时，可以在Code Composer Studio的调试状态下暂停读取设点电流值，或者调整代码在数码管上显示改值。

以上做法虽然繁琐，但是校准效果较好。如果不借助外援，则可以将第二阶段的代码整合进来做拟合之用。

### 5.4.3控制算法的稳定性[9][13]

并联输出的指标中，要求负载端压波动在2mV以内，这就要求控制算法能够快速稳定，并且稳定后不再调整。我们对于这一问题的解决方案是尽可能精确地确定两路电流值和输出电流设点值，在此基础上设置较小的调整门限值。

如果当前输出电流和目标电流相差小于门限值，则不再进行调整，达到稳定阶段。如果门限值较小，则两模块输出电流相差较小，均衡效果很好，但是在微小波动下就会脱离稳定状态，即较难稳定。反之门限值较大则不符合电流均衡的指标要求。此处我们取门限值为4mA。实测稳定时，量模块输出电流差别也基本在这个范围内。

# 6. 致谢

感谢袁焱老师、李安琪老师、陈颖琪老师、孟桂娥老师以及各位助教在实验室帮助我们解决问题，感谢各位老师在微信群里耐心地解答我们的问题，尤其要感谢袁焱老师，他不只是在讲座上为我们提供课程指导，在微信群中也无分巨细地回答每一个同学的疑问，甚至还拿出时间亲手为同学检查排错。也多亏了袁老师的帮助，我们解决了实验中的难题，同时也感谢老师们在网上提供的详细的学习资料帮助我们更好地自我学习！

同时感谢实验中与我们探讨问题、互相帮助，在硬件、软件调试过程中传授经验的各位同学！

# 7. 参考文献

[1] 工程实践与科技创新[3A]讲座1：课程事项和任务介绍.pptx, ftp://202.120.39.248/工程实践与科技创新-3A

[2] TPS40200 [J/OL]. http://www.ti.com.cn/product/cn/tps40200.

[3] DAC6571, http://www.ti.com.cn/product/cn/dac6571.

[4]模数转换-百度百科 .https://wapbaike.baidu.com/

[5]指导材料：第一阶段任务和中期检测的技术要领20181022.pdf//202.120.39.248/工程实践与科技创新-3A

[6]工程实践与科技创新[3A]课程任务要求20180924.docx//202.120.39.248/工程实践与科技创新-3A

[7]指导材料：宽输入非同步降压DCDC控制器芯片TPS40200DATASHEET导读 .pdf//202.120.39.248/工程实践与科技创新-3A

[8]20190906稳压源学生参考电路图.pdf//202.120.39.248/工程实践与科技创新-3A

[9] 工程实践与科技创新[3A]-第05组(冯冬辉)设计报告.pdf/2018级工程实践与科技创新 3A 第 05 组实验报告
[10] 工程实践与科技创新[3A]讲座2：基于TPS40200的DC-DC电路设计原理简析.pptx//202.120.39.248/工程实践与科技创新-3A
[11] 工程实践与科技创新[3A]测试方法和评分规则20190909.docx//202.120.39.248/工程实践与科技创新-3A

[12]20190906稳流源学生参考电路图.pdf//202.120.39.248/工程实践与科技创新-3A

[13]工程实践与科技创新[3A]讲座4：第二、第三阶段任务的技术要领.pptx, ftp://202.120.39.248/工程实践与科技创新-3A

# 8. 附录A 系统操作说明书

整个系统的实物图如下:

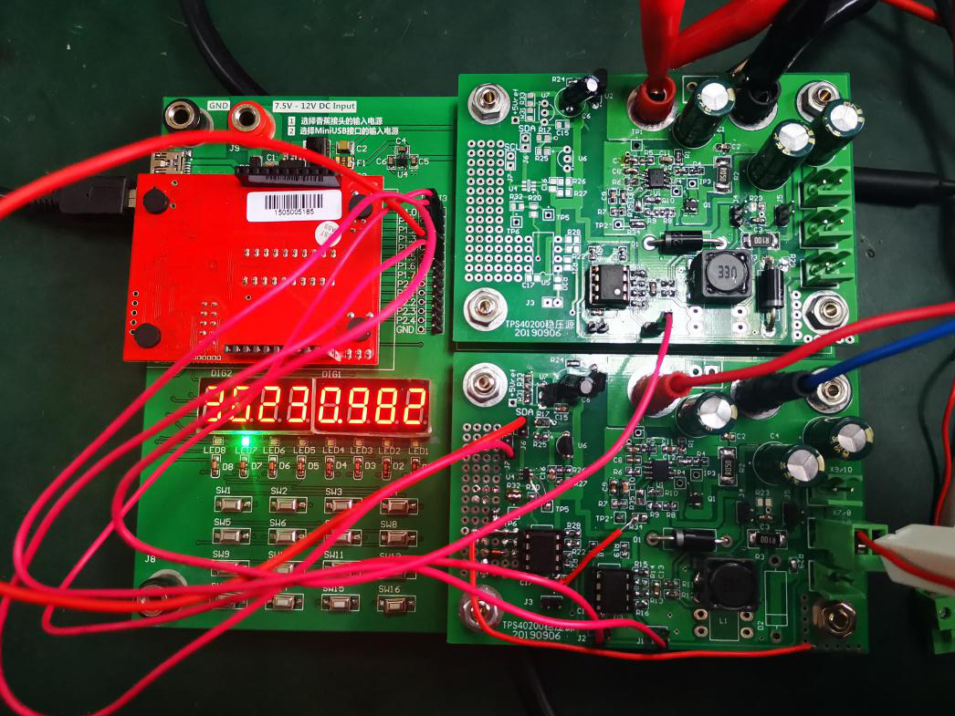
[picture p17: figure]

图22 最终系统的实物图

## 8.1 系统功能

本系统为DC-DC开关电源模块输出系统，可以将10-20V的直流电压转换为电压5V稳定的直流电压。本品有三种工作模式，单体稳压电源，单体稳流电源，并联式稳压供电系统。系统使用MSP430单片机作为控制部件，实现了对两个电源模块的输出电流进行实时监控和动态精密均流调整。如上图所示右上模块为稳压源，右下模块为稳流源。

## 8.2 使用方法

在稳流源的红黑端口接入输入电压10-20V，用跳线连接两模块的电压输入端口，并按照如下指示用杜邦线连接单片机和两模块：
P1.0 接稳流源/稳压源J2，测量其输出电压
P1.1 接稳流源J1，测稳流源输出电流
P1.2 接稳压源J1，测稳压源输出电流
P1.4 接稳流源J6
P1.5 接稳流源J7

## 8.3 稳压电源模式

系统通电后，按下按键SW1进入稳压电源模式，指示灯LED8亮，将P1.0接稳压源J2。输入10~20V直流电压，输出5V直流电压，数码管上左边显示输出电压（V），右边显示输出电流（A）。该模块有限流保护功能，当输出电流超过1.1-1.9A时，输出电流为0，换用较大电阻可以恢复。

## 8.4 稳流电源模式

接通电源后后，按下按键SW2进入稳压电源模式，指示灯LED7亮，将P1.0接稳稳流源J2。输入10~20V直流电压，电流源能稳定输出0.1-1.2A电流。再按SW2可以切换屏显。第一屏数码管右边显示为输出电流设点（A），此时通过按键SW5-SW8可以调整输出电流（精度10mA），其中按下SW5输出电流-10mA，按下SW6输出电流-100mA，按下SW7输出电流+100mA，按下SW8输出电流+10mA。第二屏显示实测输出电压电流，数码管上左边显示输出电压（V），右边显示输出电流（A）。该模块有限压保护功能，输出电压最大约为5.2V，换用较小电阻可以恢复。

## 8.5 并联式稳压供电模式

接通电源前，将两模块负载端用跳线并联，开机后，按下按键SW3进入稳压电源模式，指示灯LED6亮，将P1.0接稳流源J2（或稳压源J2）。输入10~20V直流电压，输出5V直流电压，额定电流2A。再按SW3可以切换屏显。第一屏右边显示为并联输出电压。第二屏左边显示为稳流源输出电流，右边为稳压源输出电流。

## 8.6 安全提醒

加电一段后，水泥电阻工作时温度很高，插拔时请夹住底部塑料部分操作以免烫伤。同时在实验中连线要注意不要连错以免发生短路对烧坏电路元件。

# 9. 附录B 测试和分析

## 9.1 测试项目和方法

检测项目 | 检测条件 | 检测方法 | 评分规则
输出电压绝对精度 (5) | Rload=5.1Ω | 测量输出电压。 | 4.85~5.15V，得2.5分；其他得0分。
| Rload=∞ (空载) | | 4.85~5.15V，得2.5分；其他得0分。
输出过流保护和恢复 (3) | 输出10.0V±0.1V | Rload=5.1Ω//5.1Ω；测量输出电压 | 输出能有效关断，得1.5分；其他得0分。
| | Rload=5.1Ω；再次测量输出电压 | 在上项有效关断基础上，能自动恢复正常输出，得1.5分；其他得0分。
负载调整率 (2) | 输入10.0V±0.1V | Rload=5.1Ω和10Ω | 输出电压约为5V，且变化小于0.01V，得2分； 大于等于0.01V，小于等于0.02V，得1分； 其他，得0分。
电源转换效率 (18) | 输入10.0V±0.1V；Rload=5.1Ω | 测量输入电压、输入电流，输出电压（直接测量负载水泥电阻本体引脚部位，排除长导线的电阻的影响），负载以5.1Ω计，计算效率。 | 若效率大于95%，得18分； 在80%至95%之间，得分计算公式（结果保留1位小数） 小于80%，得0分；
电压调整率 (2) | Rload=5.1Ω | 输入从10V变化到20V | 输出电压约为5V，且变化小于0.01V，得2分； 大于等于0.01V，小于等于0.025V，得1分； 其他，得0分。
输出纹波 (10) | 输入20.0V±0.1V；Rload=5.1Ω；示波器探头X10，示波器带宽限制调为20MHz | 示波器（只用单通道，防止通道间干扰）观测交流纹波。 | 若纹波Upp小于等于30mV，得10分； 在30mV至100mV间，得分计算公式（结果保留1位小数） 超过100mV为不合格，得0分。
违规使用电位器 | | 目视检查 | 每使用一个电位器，扣3分。
单片机监测电压和电流 (5) | 输入10.0V±0.1V；评测官任选一种工作状态（空载除外）进行检测 | 测量输出电压，与单片机显示数值对比 | 误差小于等于0.02V，得2分； 小于等于0.05V，大于0.02V，得1分； 其他，得0分。
| | 测量输出电流，与单片机显示数值对比 | 误差小于等于0.01A，得3分； 小于等于0.05A，大于0.01A，得1分； 其他，得0分。

表8 DC-DC稳压电源模块基本技术指标

检测项目 | 检测条件 | 检测方法 | 评分规则
输出电流绝对精度 (8) | 输入10.0V±0.1V；评测官指定 设定输出电流0.1、0.2或0.3A Rload=5.1Ω或10Ω | 测量输出电流采样电阻端压 | 围绕精确数值±0.5mV以内波动，得4分；±1.0mV以内波动，得2分；其他得0分。
| 输入10.0V±0.1V；设定输出电流0.8A 评测官指定 Rload=3Ω或5.1Ω | | 78.0~82.0mV波动，得4分；74.0~86.0mV波动，得2分；其他得0分。
输出限压保护和恢复 (2) | 输入10.0V±0.1V；设定输出电流1.0A | Rload=10Ω 测量输出电压 | 限压输出5.0~5.4V，且更换负载电阻后输出电流恢复正常，得2分；其他得0分。
| | 不下电更换Rload=3Ω 测量输出电流采样电阻端压
印刷电路板违规使用电位器 | | 目视检查 | 每使用一个电位器，扣3分。
单片机监测电压和电流 (5) | 输入10.0V±0.1V；评测官任选一种输出≥0.5A的工作状态进行检测 | 测量输出电压，与单片机显示数值对比 | 误差小于等于0.02V，得2分； 小于等于0.05V，大于0.02V，得1分；其他，得0分。
| | 测量输出电流，与单片机显示数值对比 | 误差小于等于0.01A，得3分； 小于等于0.05A，大于0.01A，得1分；其他，得0分。

表9 DC-DC稳流电源基本技术指标

检测项目 | 检测条件 | 检测方法 | 评分规则
负载均衡度 (12) | 输入10.0V±0.1V； Rload=5.1Ω//10Ω | 测量并联输出电压； 测量两路输出电流采样电阻端压 | 并联输出电压须稳定在4.85~5.15V，否则不得分。 第一档：负载均衡误差[注1]小于等于2%，且两路电阻端压各自波动均小于等于2mV，得6分； 第二档：不符合第一档，但负载均衡误差小于等于5%，且两路电阻端压各自波动均小于等于8mV，得4分； 第三档：不符合第一、二档，但负载均衡误差小于等于15%，且两路电阻端压各自波动均小于等于24mV，得2分； 其他得0分。
| 不下电更换 Rload=5.1Ω//5.1Ω | | 并联输出电压须稳定在4.85~5.15V，否则不得分。 第一档：负载均衡误差小于等于2%，且两路电阻端压各自波动均小于等于2mV，得6分； 第二档：不符合第一档，但负载均衡误差小于等于5%，且两路电阻端压各自波动均小于等于8mV，得4分； 第三档：不符合第一、二档，但负载均衡误差小于等于15%，且两路电阻端压各自波动均小于等于24mV，得2分； 其他得0分。
单片机监测电压和电流 (3) | 输入10.0V±0.1V；评测官任选一种工作状态（输出总电流大于0.8A）进行检测 | 测量输出电压，与单片机显示数值对比 | 误差小于等于0.02V，得1分； 小于等于0.05V，大于0.02V，得0.5分；其他，得0分。
| | 测量第一路输出电流，与单片机显示数值对比 | 误差小于等于0.01A，得1分； 小于等于0.05A，大于0.01A，得0.5分；其他，得0分。
| | 测量第二路输出电流，与单片机显示数值对比 | 误差小于等于0.01A，得1分； 小于等于0.05A，大于0.01A，得0.5分；其他，得0分。

[注1] 负载均衡误差计算公式

表10 并联输出基本技术指标

## 9.2 测试的资源

测试设备：万用表，实验台，稳压电源，电脑一台，示波器一台，电源引线及杜邦线若干直流稳压源一台。

测试环境：实验室，CCS(Code Composer Studio)。

## 9.3 测试结果及分析

检测项目 | 检测条件 | 检测方法或步骤 | 记录【评测官填写】
输出电压绝对精度 | 输入10V，Rload=5.1Ω | 测量输出电压 | 输出电压= 5.055 V
| 输入10V，Rload=∞ (空载) | | 输出电压= 5.063 V
输出过流保护和恢复 | 输入10V | Rload=5.1Ω//5.1Ω；测量输出电压 | 输出电压= 0.13m V
| | Rload=5.1Ω；再次测量输出电压 | 输出电压= 5.056 V
负载调整率 | 输入10V，Rload=5.1Ω | 测量输出电压 | 输出电压= 5.056 V
| 输入10V，Rload=10Ω | | 输出电压= 5.057 V
电源转换效率 | 输入10V，Rload=5.1Ω | 测量输入电压、电流， 负载电阻两引脚上输出电压。 | 输入电压= 9.9 V 输入电流= 0.56 A 输出电压= 5.056 V
电压调整率 | Rload=5.1Ω | 输入从10V变化到20V | 变化前= 5.056 V 变化后= 5.051 V
输出纹波 | 输入20V，Rload=5.1Ω | 示波器探头X10，示波器带宽限制调为20MHz，示波器只用单通道（防止通道间干扰） | 输出纹波= 33 mVpp
单片机监测电压和电流 | 输入10V，作品应正确插装合成一体 | 测量输出电压 记录显示数值（以V为单位） | 实测电压= 5.057 V 显示电压= 5.054 V
| | 测量0.1Ω两端电压 记录显示数值（以A为单位） | 实测0.1Ω电压= 98.66m V 显示电流= 0.985 A

表 11 中期检测记录表

检测项目 | 检测条件 | 检测方法或步骤 | 记录【评测官填写】
输出电流绝对精度 | 输入10V，设定0.2A Rload=10Ω | 测量0.1Ω端电压 | 端电压= 19.23 mV （可计波动区间）
| 输入10V，设定0.8A Rload=5.1Ω | | 端电压= 77.53 mV （可计波动区间）
输出限压保护和恢复 | 输入10V，设定1.0A | Rload=10Ω；测量输出电压 | 输出电压= 5.227 V
| | 不下电更换Rload=3Ω；测量0.1Ω端电压 | 端电压= 97.48 mV （可计波动区间）
单片机监测电压和电流 | 输入10V，设定0.8A Rload=3Ω | 测量输出电压 记录显示数值（V为单位） | 实测电压= 3.891 V 显示电压= 3.900 V
| | 测量0.1Ω两端电压 记录显示数值（A为单位） | 实测端电压= 77.54 mV 显示电流= 0.787 A
备注 | （若有违规使用电位器，可记录数目）

表12 第二阶段检测记录表

检测项目 | 检测条件 | 检测方法或步骤 | 记录【评测官填写】
负载均衡度 | 输入10V； Rload=5.1Ω//10Ω | 测量并联输出电压 测量0.1Ω端电压 | 并联输出电压= 4.956 V （可计波动区间） 第1路端电压= 72.80 mV 第2路端电压= 75.44 mV
| 不下电更换 Rload=5.1Ω//5.1Ω | | 并联输出电压= 4.931 V （可计波动区间） 第1路端电压= 95.04 mV 第2路端电压= 99.46 mV
单片机监测电压和电流 | 输入10V Rload=5.1Ω//5.1Ω | 测量输出电压 记录显示值（以V为单位） | 实测电压= 4.984 V 显示电压= 4.988 V
| | 测量第1路0.1Ω两端电压 记录显示值（以A为单位） | 实测端电压= 49.08 mV 显示电流= 0.507 A
| | 测量第2路0.1Ω两端电压 记录显示值（以A为单位） | 实测端电压= 49.79 mV 显示电流= 0.517 A
备注

表13 第三阶段检测记录表

从上面的表格测得的实验结果与表8、9、10中的检测指标比较，可以的得到：

对于第一阶段任务检测，我们在输出电压绝对精度，输出过流保护和恢复和电压调整率方面以及单片机监测控制都达到了满分的要求。而在电源转换效率中，我们的输入功率Pin=9.9V*0.56A=5.544W，输出功率Pout=(5.056V)²/(5.1Ω)=5.012W，效率达到了90.41%，而在纹波检测中我们输出纹波为33mV，可惜这两个项目上我们没能达到满分的标准。我们认为是焊接方面的精度不够高或者是电路的没有做出更好的改进。

对于第二阶段任务检测，输出限压保护和恢复和单片机监测电压和电流在评测官选择的工作条件下都有很好的结果，均达到了满分标准；但是稳流电源的输出电流绝对精度没有达到满分的标准，经过改动代码，发现并没有很大的改善，所以最后我们把原因归结于硬件电路的焊接，可能有些元件的焊接存在一些问题。

对于第三阶段任务检测，单片机监测电压和电流在评测官选择的工作条件下都有很好的结果，均达到了满分标准。但是负载均衡度并没有之前测试时那么好的结果，中间为了完善单片机监测的指标，我们多次改过程序的拟合函数以及小部分的程序结构，可能会对均衡度有一定的影响。

总的来说，这三个阶段的测试结果还算是差强人意，有几个地方没有达到满分的要求，无论是电路焊接还是程序代码可能还存在着不足，还存在着进步的空间。

# 10. 附录C WEBENCH设计工具练习

## 10.1 设计要求

选择TPS40170作为电源控制芯片，使用WEBENCH设计一个DC-DC降压电源，输入输出参数如下：

- 输入电压：10V-20V
- 输出电压：5V
- 输出电流：1A

请按照步骤2-步骤5中的要求完成问题，并提交填写完成后的本文档。

## 10.2 观察开关频率对效率的影响

进入TPS40170设计方案，修改开关频率为120kHz和480kHz，在Operation Value下分别查看两种频率下的效率值。

Efficiency @120kHz = 94 %

Efficiency @480kHz = 90 %

根据上述结果分析开关频率对电源效率的影响？

答：由上述仿真结果可知，随着开关频率的增加，电源效率也有所升高。开关频率升高加快了三极管的基极信号在高低电平之间的转换，从而开关处耗能增加，电源效率降低

## 10.3 观察开关频率对输出电压纹波的影响

修改开关频率为120kHz和480kHz，在Operation Value下分别查看两种频率下的输出电压纹波值。

Vout p-p @120kHz = 95.81 mV

Vout p-p @480kHz = 4.42 mV

根据上述结果分析开关频率对输出电压纹波的影响？

答：由仿真结果可知，当开关频率升高，输出纹波峰峰值会降低；当开关频率升高时，开关导通深度降低，电压纹波峰峰值也随之降低。

## 10.4 观察输出电容对输出电压纹波的影响

将开关频率设为120kHz，在原理图中查看输出电容Cout的参数：

电容型号： EEE-FK1E330P .

电容值Cap = 33 uF

ESR = 360 mΩ

在原理图中将输出电容型号替换为10TPB33M（33uF，ESR=70mΩ），对比更换前和更换后的输出电压纹波。

更换前Vout p-p = 95.81 mV

更换后Vout p-p = 20.59 mV

## 10.5 导出设计报告

使用PRINT REPORT功能将设计方案导出为PDF文档。将PDF文档第一页截图之后粘贴于此下方。

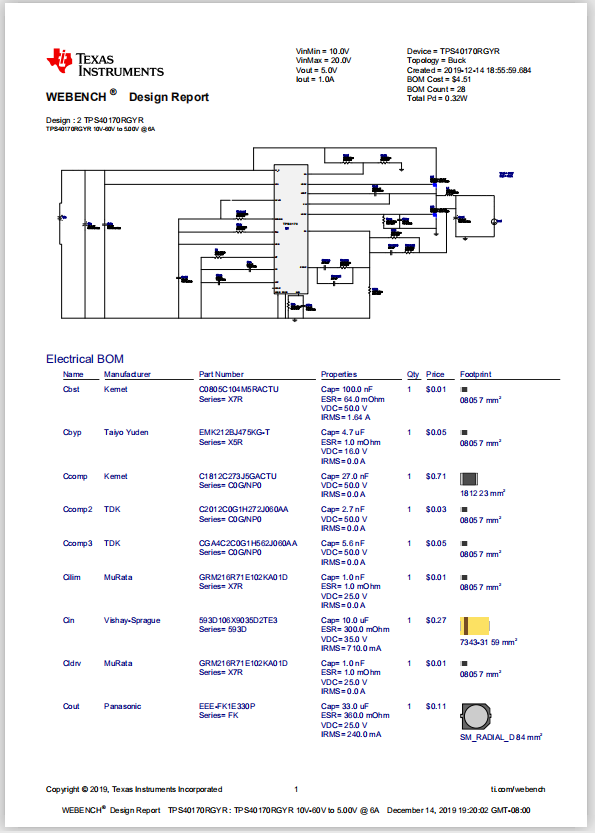
[picture p18: figure]
捕获

图23 Cout型号为 EEE-FK1E330P时的设计方案

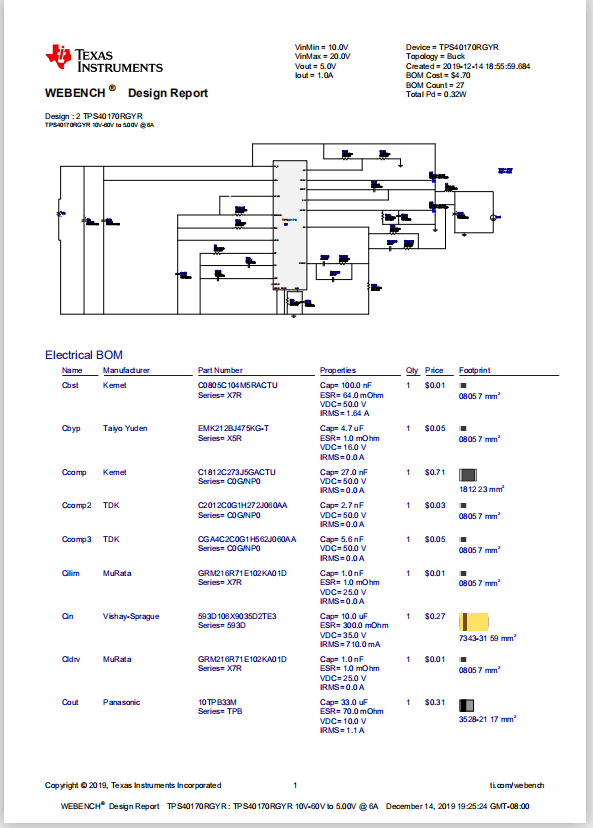
[picture p19: figure]
捕获1

图24 Cout型号为 10TPB33M时的设计方案

# 11.附录D 课程学习心得和意见建议

于前程：我是这次工科创小组的组长，首先十分感谢我的两个组员全程对我的支持，在我们的通力合作下，最终完成了这次工科创的任务，虽然最后的结果没有做到十全十美，但是实验中间学习的新的知识和能力是弥足珍贵的。我在这次实验过程中主要扮演的是设计电路的角色，中间难免会遇到一些难点，我通常会仔细翻阅老师给的技术资料，然后再从网上查询相关的电路元件的参数功能，虽然过程比较复杂，但是在探索的过程中我也学到了许多关于电路的新的知识，同时也对学过的电路知识有了更深的理解。当然，在电路调试的过程中，出现问题在所难免，有些我们知识经验不足，在老师的指导下，我和组员们一步步地检查，慢慢地排查问题，最终问题的解决也是让我们收获了满满的满足感，也很大程度上弥补了我在工程设计问题上的不足。最后再次感谢老师和组员们在实验过程中对我不遗余力的支持与帮助。

宋许健：工程实践创新是一门我非常喜爱的课程，本次3A课程中我也收获了颇多工程经验。在2A的课程中，代码部分总是与电路部分分开，但我此次也有幸参与了很少部分的焊接工作。虽然难点在于电路的设计，但是拿起焊枪的那份感动却油然而生。3A的代码部分并不算简单，出了问题往往不知道是软件还是硬件问题，当模块在检测前出现问题，也需要即时在代码上做出调整，在摸索中我也习得了一些调试技巧。在把代码产品化的过程中，我也学会了从工程角度考虑问题，考虑用户的需求和操作习惯。虽然时间有限、目标严苛、问题颇多，但在队友的耐心合作和老师的悉心指导下，完成任务的过程变得格外有趣。期待在4B中会有更大的收获。

韦金星：在这次课程项目中我主要负责电路焊接部分，通过这次实践，我总结了以下几点电路焊接的经验:1 焊接元件时最好把元件参数测一下，避免因为元件放的位置不对或者拿错元件导致的错误；2 焊接时不一定要按照电路图的顺序，先焊小元件再焊接大的元件更方便操作；3 焊接时要注意需要分正负的元件，确定方向正确与否。工程实践与创新这门课程不仅让我们学习了电路理论知识，也培养了我们的动手能力，更重要的是锻炼了我们的团队协作能力，能够和两位小组成员一起讨论问题，解决问题，最终完成作品实在是一段让人难忘的经历！

# 11. 附录E 软件程序清单

/* 工科创3A version:3.4

*

* ** 引脚定义 **

* P1.0 Volt J2 稳压电压/稳流电压

* P1.1 CC J1 稳流电流

* P1.2 CV J1 稳压电流

* P1.4 SDA J6 稳流

* P1.5 SCL J7 稳流

*

* ** 按键定义 **

* SW1 转到第一阶段

* SW2 转到第二阶段，再按切换显示

* SW3 转到第三阶段，再按切换显示

* SW5 第二阶段适用，输出电流-10mA

* SW6 第二阶段适用，输出电流-100mA

* SW7 第二阶段适用，输出电流+100mA

* SW8 第二阶段适用，输出电流+10mA

*

* ** 屏显定义 **

* Stage1: LED8;数码管上左边显示输出电压（V），右边显示输出电流（A）

* Stage2: LED7; Volt, CC; Shift: __, output_current.第一屏数码管右边显示为输出电流设点（A），此时通过按键SW5-SW8可以调整输出电流（精度10mA）

* 第二屏显示实测输出电压电流，数码管上左边显示输出电压（V），右边显示输出电流。该模块有限压保护功能，输出电压最大约为5.2V

* Stage3: LED6; __, Volt; Shift: CC, CV

* 第一屏左边显示为并联输出电压。第二屏左边显示为稳流源输出电流，右边为稳压源输出电流。

*/

//本程序时钟采用内部RC 振荡器。DCO：8MHz,供CPU 时钟; SMCLK：1MHz,供定时器时钟

#include <msp430g2553.h>

#include <tm1638.h> //与TM1638 有关的变量及函数定义均在该H 文件中

#include <math.h>

//////////////////////////////

// 常量定义//

//////////////////////////////

#define V_T 50

// ADC10 参考电压及量化单位

#define n_sample 32

#define N_avg 200

// 0.1s 软件定时器溢出值，5 个20ms

#define V_T100ms 5

// 0.5s 软件定时器溢出值，25 个20ms

#define V_T500ms 25

// 软件定时器溢出值，N_ctrl 个20ms

#define V_T_ctrl 5

//DAC6571 操作P1.4 接SDA(pin4),P1.5 接SCL(pin5)

#define SCL_L P1OUT&=~BIT5

#define SCL_H P1OUT|=BIT5

#define SDA_L P1OUT&=~BIT4

#define SDA_H P1OUT|=BIT4

#define SDA_IN P1OUT|=BIT4; P1DIR&=~BIT4; P1REN|=BIT4

#define SDA_OUT P1DIR|=BIT4; P1REN&=~BIT4

#define output_current_max 4999

#define DAC6571_address 0x98 // 1001 10 A0 0 A0=0

//////////////////////////////

// 变量定义//

//////////////////////////////

// ADC10 变量定义

unsigned int sample[3]={0};//存放ADC 采样结果（一次转换产生的两个结果）

unsigned int sample_v[n_sample] = {0};

unsigned int sample_i1[n_sample] = {0};

unsigned int sample_i2[n_sample] = {0};

unsigned int i_sample = 0;

unsigned int iter_avg = 0;

long v_sum, i1_sum, i2_sum;

unsigned char stage = 3; // first, second, third

unsigned char shift=0; // 切换屏显

int Volt, CCurrent, VCurrent; // 电压， 稳流源电压，稳压源电压

// 软件定时器计数

unsigned char clock100ms=0;

unsigned char clock500ms=0;

unsigned char clock=0;

// 软件定时器溢出标志

unsigned char clock100ms_flag=0;

unsigned char clock500ms_flag=0;

unsigned char clock_flag=0;

// 测试用计数器

unsigned int test_counter=0;

// 8 位数码管显示的数字或字母符号

// 注：板上数码位从左到右序号排列为4、5、6、7、0、1、2、3

unsigned char digit[8]={' ',' ',' ',' ',' ',' ',' ',' '};

// 8 位小数点1 亮0 灭

// 注：板上数码位小数点从左到右序号排列为4、5、6、7、0、1、2、3

unsigned char pnt=0x11;

// 8 个LED 指示灯状态，每个灯4 种颜色状态，0 灭，1 绿，2 红，3 橙（红+绿）

// 注：板上指示灯从左到右序号排列为7、6、5、4、3、2、1、0

// 对应元件LED8、LED7、LED6、LED5、LED4、LED3、LED2、LED1

unsigned char led[]={0,0,0,0,0,0,0,1};

// 当前按键值

unsigned char key_code=0;

unsigned char key_cnt=0;

// DAC6571

unsigned int dac6571_code=0x0800;

unsigned int output_current=2500;

unsigned char dac6571_flag=0;

//////////////////////////////

// 系统初始化//

//////////////////////////////

// I/O 端口和引脚初始化

void Init_Ports(void)

{

P2SEL &= ~(BIT7+BIT6); //P2.6、P2.7 设置为通用I/O 端口（GPIO）

//因两者默认连接外晶振，故需此修改

P2DIR |= BIT7 + BIT6 + BIT5; //P2.5、P2.6、P2.7 设置为输出

//本电路板中三者用于连接显示和键盘管理器TM1638，工作原理详见其DATASHEET

P1SEL |= (BIT0+BIT1+BIT2); //P1.0、P1.1 设置为通用I/O 端口（GPIO）

P1DIR &=~ (BIT0+BIT1+BIT2); //P1.0、P1.1 设置为输入

P1DIR |= BIT4 + BIT5; //P1.4、P1.5 设置为输出

P1OUT |= BIT4 + BIT5; //P1.4、P1.5 设置为高电平

}

// 定时器TIMER0 初始化，循环定时20ms

void Init_Timer0(void)

{

TA0CTL = TASSEL_2 + MC_1 ; // Source: SMCLK=1MHz, UP mode,

TA0CCR0 = 20000; // 1MHz 时钟,计满20000 次为20ms

TA0CCTL0 = CCIE; // TA0CCR0 interrupt enabled

}

// ADC10 初始化

void Init_ADC10()

{

ADC10CTL1 = CONSEQ_1 + INCH_2; // 3 通道单次转换, 最大转换通道为A2

ADC10CTL0 = ADC10SHT_2 + ADC10ON + ADC10IE + MSC;

//采样保持时间为16 x ADC10CLKs，ADC 内核开，中断使能MSC 多次转换选择开

//参考电压选默认值VCC 和VSS

ADC10DTC1 = 0x03;

ADC10AE0 |= BIT0+BIT1+BIT2;// 使能模拟输入脚A0 A1 A2

}

// MCU 器件初始化，注：会调用上述函数

void Init_Devices(void)

{

WDTCTL = WDTPW + WDTHOLD; // Stop watchdog timer，停用看门狗

if (CALBC1_8MHZ ==0xFF || CALDCO_8MHZ == 0xFF)

{

while(1); // If calibration constants erased, trap CPU!!

}

//设置时钟，内部RC 振荡器。DCO：8MHz,供CPU 时钟; SMCLK：1MHz,供定时器时钟

BCSCTL1 = CALBC1_8MHZ; // Set range

DCOCTL = CALDCO_8MHZ; // Set DCO step + modulation

BCSCTL3 |= LFXT1S_2; // LFXT1 = VLO

IFG1 &= ~OFIFG; // Clear OSCFault flag

BCSCTL2 |= DIVS_3; // SMCLK = DCO/8

Init_Ports(); //调用函数，初始化I/O 口

Init_Timer0(); //调用函数，初始化定时器0

Init_ADC10(); //初始化ADC

_BIS_SR(GIE); //开全局中断

//all peripherals are now initialized

}

void dac6571_byte_transmission(unsigned char byte_data)

{

unsigned char i,shelter;

shelter = 0x80;

for (i=1; i<=8; i++)

{

if ((byte_data & shelter)==0) SDA_L;

else SDA_H;

SCL_H; SCL_L;

shelter >>= 1;

}

SDA_IN;

SCL_H; SCL_L;

SDA_OUT;

}

void dac6571_fastmode_operation(void)

{

unsigned char msbyte,lsbyte;

SCL_H; SDA_H; SDA_L; SCL_L; // START condition

dac6571_byte_transmission(DAC6571_address);

msbyte = dac6571_code/256;

lsbyte = dac6571_code - msbyte * 256;

dac6571_byte_transmission(msbyte);

dac6571_byte_transmission(lsbyte);

SDA_L; SCL_H; SDA_H; // STOP condition

}

//////////////////////////////

// 中断服务程序//

//////////////////////////////

//20ms 软中断

// Timer0_A0 interrupt service routine

#pragma vector=TIMER0_A0_VECTOR

__interrupt void Timer0_A0 (void)

{

// 0.1 秒钟软定时器计数

if (++clock100ms>=V_T100ms)

{

clock100ms_flag = 1; //当0.1 秒到时，溢出标志置1

clock100ms = 0;

} // 0.5 秒钟软定时器计数

if (++clock500ms>=V_T500ms)

{

clock500ms_flag = 1; //当0.5 秒到时，溢出标志置1

clock500ms = 0;

}

if (++clock>=V_T_ctrl)

{

clock_flag = 1; //当0.1 秒到时，溢出标志置1

clock = 0;

}

// 刷新全部数码管和LED 指示灯

//TM1638_RefreshDIGIandLED(digit,pnt,led);

// 检查当前键盘输入，0 代表无键操作，1-16 表示有对应按键

// 键号显示在两位数码管上

key_code=TM1638_Readkeyboard();

if (key_code != 0)

{

if (key_cnt<4) key_cnt++;

else if (key_cnt==4)

{

if (key_code==1)

{

stage = 1;

shift = 0;

}

else if (key_code==2)

{

stage = 2;

shift = !shift;

output_current = (int)(output_current/10)*10;

}

else if (key_code==3)

{

stage = 3;

shift = !shift;

}

else if(key_code>=5 && key_code<=8)

{

if(stage==2)

{

if (key_code==5)

{

if (output_current > 10)

{

output_current-=10;

dac6571_flag =1;

}

}

else if (key_code==6)

{

if (output_current > 100)

{

output_current-=100;

dac6571_flag =1;

}

}

else if (key_code==7)

{

if (output_current < output_current_max-100)

{

output_current+=100;

dac6571_flag =1;

}

}

else if (key_code==8)

{

if (output_current < output_current_max-10)

{

output_current+=10;

dac6571_flag =1;

}

}

}

}

key_cnt =5;

}

} else key_cnt=0;

}

////ADC10 中断服务程序

#pragma vector=ADC10_VECTOR

__interrupt void ADC10ISR (void)

{

sample_v[i_sample] = sample[2];

sample_i1[i_sample] = sample[1];

sample_i2[i_sample] = sample[0];

}

//////////////////////////////

// 主程序//

//////////////////////////////

int main(void)

{

float temp;

Init_Devices( );

while (clock100ms<3); // 延时60ms 等待TM1638 上电完成

init_TM1638(); //初始化TM1638

dac6571_flag = 1;

while(1)

{

//ADC10 转换

ADC10CTL0 |= ENC + ADC10SC;

while(ADC10CTL1 & BUSY);//等待ADC10 转换完成

ADC10SA = (unsigned int)sample;

ADC10CTL0 &= ~ENC;

++i_sample;

//当采满n_sample 个样本后

if(i_sample == n_sample)

{

i_sample = 0;

unsigned int k = 0;

for( k = 0 ; k < n_sample; ++k)

{

v_sum += sample_v[k];

i1_sum += sample_i1[k];

i2_sum += sample_i2[k];

}

++iter_avg;

if (iter_avg == N_avg)

{

iter_avg = 0;

//Volt = 6.9509*v_sum/n_sample/N_avg+3.652;

//CCurrent = 3.5303*i1_sum/n_sample/N_avg+8.9375;

//VCurrent = 3.4792*i2_sum/n_sample/N_avg-40.352;

//这是初始的经验公式，后续根据定标所得参数进行了一定修改

Volt = 6.9919*v_sum/n_sample/N_avg+3.6753;

CCurrent = 3.5065*i1_sum/n_sample/N_avg+8.9946;

VCurrent = 3.4858*i2_sum/n_sample/N_avg-40.514;

v_sum = 0;

i1_sum = 0;

i2_sum = 0;

if (stage==1)

{

digit[4] = (Volt/1000)%10;

digit[5] = (Volt/100)%10;

digit[6] = (Volt/10)%10;

digit[7] = (Volt)%10;

digit[0] = (VCurrent/1000)%10;

digit[1] = (VCurrent/100)%10;

digit[2] = (VCurrent/10)%10;

digit[3] = (VCurrent)%10;

}

else if (stage==2 && shift==0)

{

digit[4] = ' ';

digit[5] = ' ';

digit[6] = ' ';

digit[7] = ' ';

digit[0] = (output_current/1000)%10;

digit[1] = (output_current/100)%10;

digit[2] = (output_current/10)%10;

digit[3] = (output_current)%10;

}

else if (stage==2 && shift==1)

{

digit[4] = (Volt/1000)%10;

digit[5] = (Volt/100)%10;

digit[6] = (Volt/10)%10;

digit[7] = (Volt)%10;

digit[0] = (CCurrent/1000)%10;

digit[1] = (CCurrent/100)%10;

digit[2] = (CCurrent/10)%10;

digit[3] = (CCurrent)%10;

}

else if (stage==3 && shift==0)

{

digit[4] = (CCurrent/1000)%10;

digit[5] = (CCurrent/100)%10;

digit[6] = (CCurrent/10)%10;

digit[7] = (CCurrent)%10;

digit[0] = (VCurrent/1000)%10;

digit[1] = (VCurrent/100)%10;

digit[2] = (VCurrent/10)%10;

digit[3] = (VCurrent)%10;

}

else if (stage==3 && shift==1)

{

digit[4] = (Volt/1000)%10;

digit[5] = (Volt/100)%10;

digit[6] = (Volt/10)%10;

digit[7] = (Volt)%10;

digit[0] = ' ';

digit[1] = ' ';

digit[2] = ' ';

digit[3] = ' ';

}

}

}

if (clock_flag==1) //100ms

{

clock_flag=0;

if(stage==2 && dac6571_flag==1)

{

dac6571_flag=0;

temp = (1.5*output_current-127.83)*4096.0/(output_current_max+1);

dac6571_code = temp;

dac6571_fastmode_operation();

}

if(stage==3)

{

int tmp_int = (CCurrent+VCurrent)/2+2;

if (abs(output_current - tmp_int)>4)

output_current = (tmp_int + output_current)/2;

else

output_current = output_current;

temp = (1.5*output_current-127.83)*4096.0/(output_current_max+1);

dac6571_code = temp;

dac6571_fastmode_operation();

}

}

if (clock500ms_flag==1) // 检查0.5 秒定时是否到

{

clock500ms_flag=0;

// 8 个指示灯以走马灯方式，每0.5 秒向右（循环）移动一格

int k=0;

for (k=7;k>=0;k--) led[k]=0;

led[8-stage]=1;

// 不懂为啥，不能注释

TM1638_RefreshDIGIandLED(digit,pnt,led);

}

}

}

上海交通大学 电子信息与电气工程学院 地 址：东川路800 邮 编：200240

上海交通大学 电子信息与电气工程学院 地址：上海市华山路1954号 邮政编码：200030

项目名称： DC-DC开关电源系统设计 设计小组编号：33 设计小组名单：于前程(组长)、韦金星、宋许健 上海交通大学 电子信息与电气工程学院

第13页 上海交通大学 电子信息与电气工程学院

第2页 共4页 上海交通大学 电子信息与电气工程学院

第1页 共4页 上海交通大学 电子信息与电气工程学院

技术文件 完成时间：2019.12.9 工程实践与科技创新[3A] 设计报告 2019年
