lin06121/DCDC_constant_current_power_supply/ti1294/examples/boards/ek-tm4c1294xl/boot_emac_flash/build_log.txt

*** Using Compiler 'V5.06 update 7 (build 960)', folder: 'E:\Developtool\keil\ARM\ARM_Compiler_5.06u7\Bin'
Rebuild target 'boot_emac_flash'
Before Build - User command #1: armcc --device DLM -I . -E -o bl_config.inc ..\..\..\..\boot_loader\bl_config.c
*** Error: CreateProcess failed, Command: 'armcc --device DLM -I . -E -o bl_config.inc ..\..\..\..\boot_loader\bl_config.c'
compiling bl_check.c...
compiling bl_packet.c...
compiling bl_uart.c...
compiling bl_crc32.c...
compiling bl_autobaud.c...
assembling bl_startup_rvmdk.S...
compiling bl_decrypt.c...
compiling bl_i2c.c...
compiling bl_can.c...
compiling bl_ssi.c...
compiling ota_hooks.c...
compiling bl_main.c...
compiling bl_flash.c...
compiling bl_usbfuncs.c...
compiling bl_usb.c...
compiling bl_emac.c...
".\rvmdk\boot_emac_flash.axf" - 1 Error(s), 0 Warning(s).
Target not created.
Build Time Elapsed:  00:00:01
