lin06121/DCDC_constant_current_power_supply/A2000TM4电原理图_v3.pdf

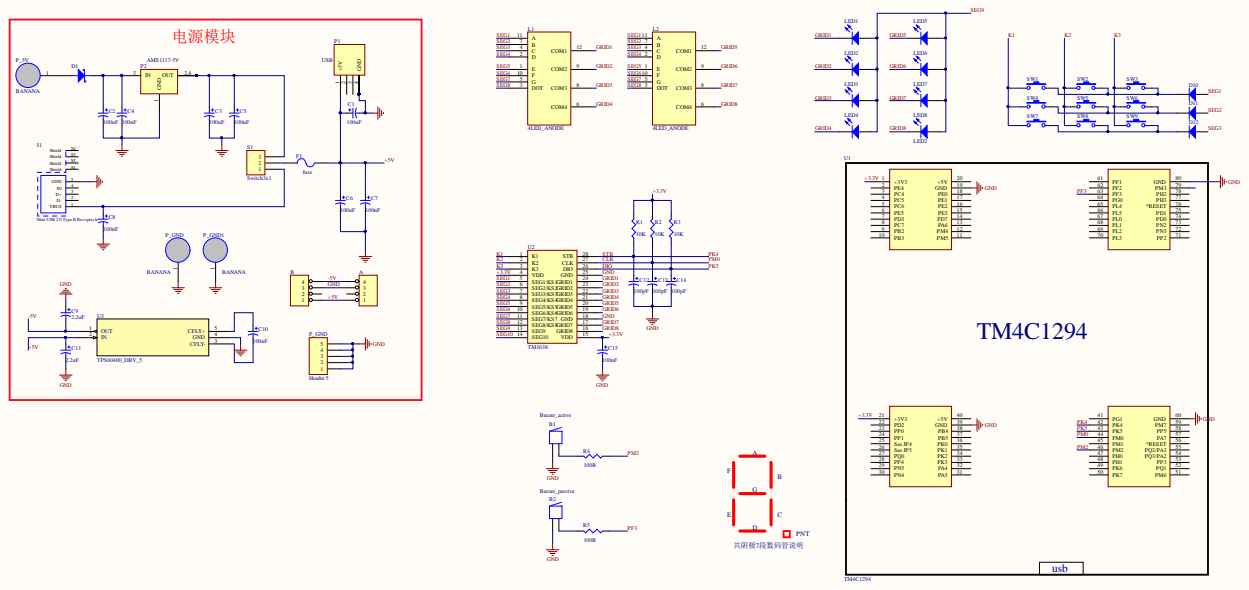
[picture p73: page 1]

Mini USB 2.0 Type B Receptacle

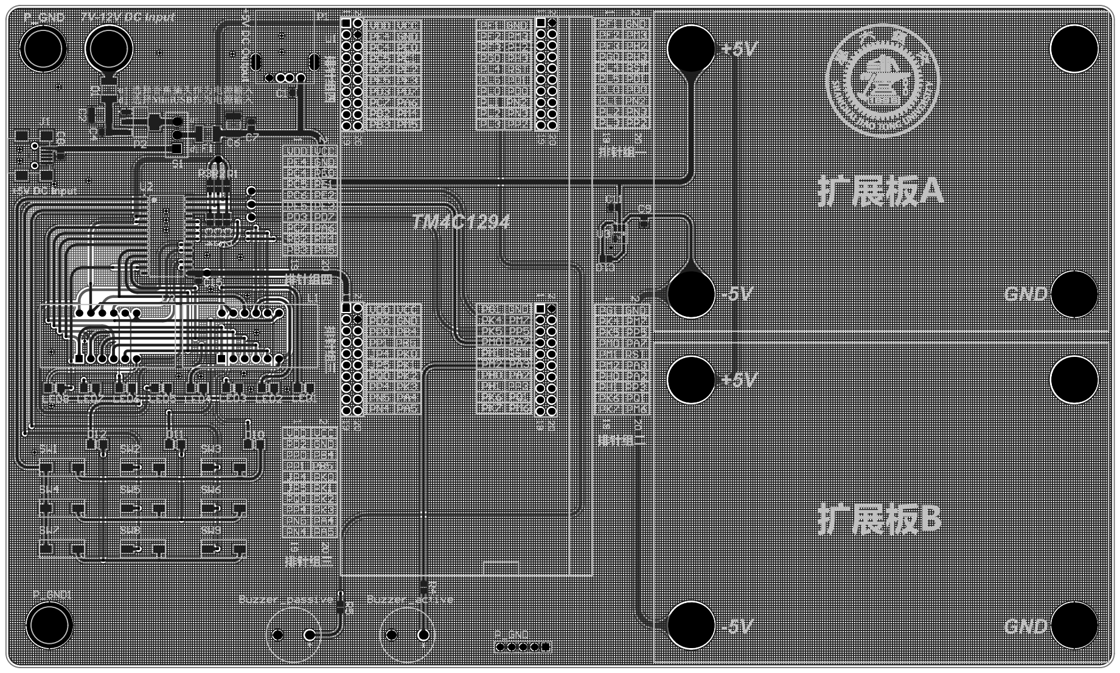
[picture p74: page 2]

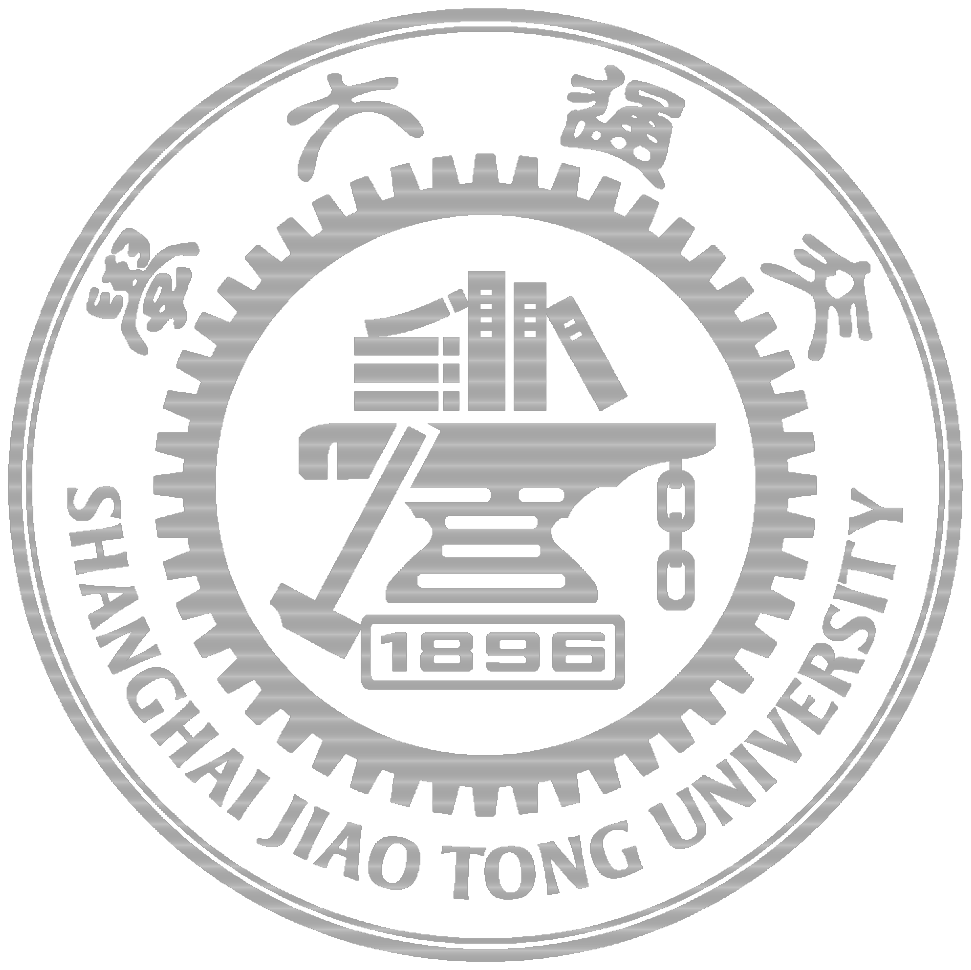
[picture p75: page 3]

Comment | Description | Designator | Footprint | LibRef | Quantity
| 4 Pin Header | A, B | SYB | 4 HEADER | 2
Buzzer_active | Buzzer | B1 | Buzzer | Buzzer | 1
Buzzer_passive | Buzzer | B2 | Buzzer | Buzzer | 1
Cap Pol3 | Polarized Capacitor (Surface Mount) | C1, C4, C5, C7, C8, C9, C10, C11, C12, C13, C14, C15 | C0805 | Cap Pol3 | 12
Cap Pol3 | Polarized Capacitor (Surface Mount) | C2, C3, C6 | 1812 | Cap Pol3 | 3
| Schottky Diode | D1 | 1812 | DIODE SCHOTTKY | 1
Diode | Default Diode | D10, D11, D12 | 1206 | Diode | 3
fuse | fuse | F1 | 1812 | fuse | 1
Mini USB 2.0 Type B Receptacle | Mini USB 2.0 Type B, Receptacle, Horizontal, SMT | J1 | 65100516121 | 65100516121 | 1
4LED_ANODE | 4LED_ANODE | L1, L2 | 4LED_ANODE | 4LED_ANODE | 2
LED2 | Typical RED, GREEN, YELLOW, AMBER GaAs LED | LED1, LED2, LED3, LED4, LED5, LED6, LED7, LED8 | 1206 | LED2 | 8
USB | | P1 | USB | USB | 1
AMS1117-5V | | P2 | SOT223 | AMS1117-3.3 | 1
BANANA | BANANA | P_5V, P_GND, P_GND1 | BANANA | BANANA | 3
Header 5 | Header, 5-Pin | P_GND | HDR1X5 | Header 5 | 1
Res3 | Resistor | R1, R2, R3, R4, R5 | C0805 | Res3 | 5
Switch3x1 | Switch3x1 | S1 | Swicth3x1 | Switch3x1 | 1
| | SW1, SW2, SW3, SW4, SW5, SW6, SW7, SW8, SW9 | SW-PB | SW-PB | 9
TM4C1294 | TM4C1294 | U1 | TM4C1294_pcb | TM4C1294 | 1
TM1638 | TM1638 | U2 | SOL-28_N | TM1638 | 1
TPS60400_DBV_5 | Imported | U3 | DBV5 | TPS60400_DBV_5 | 1
