lin06121/DCDC_constant_current_power_supply/problem/稳压源学生参考电路图.pdf

## Vin+

## DC-DC主体电路

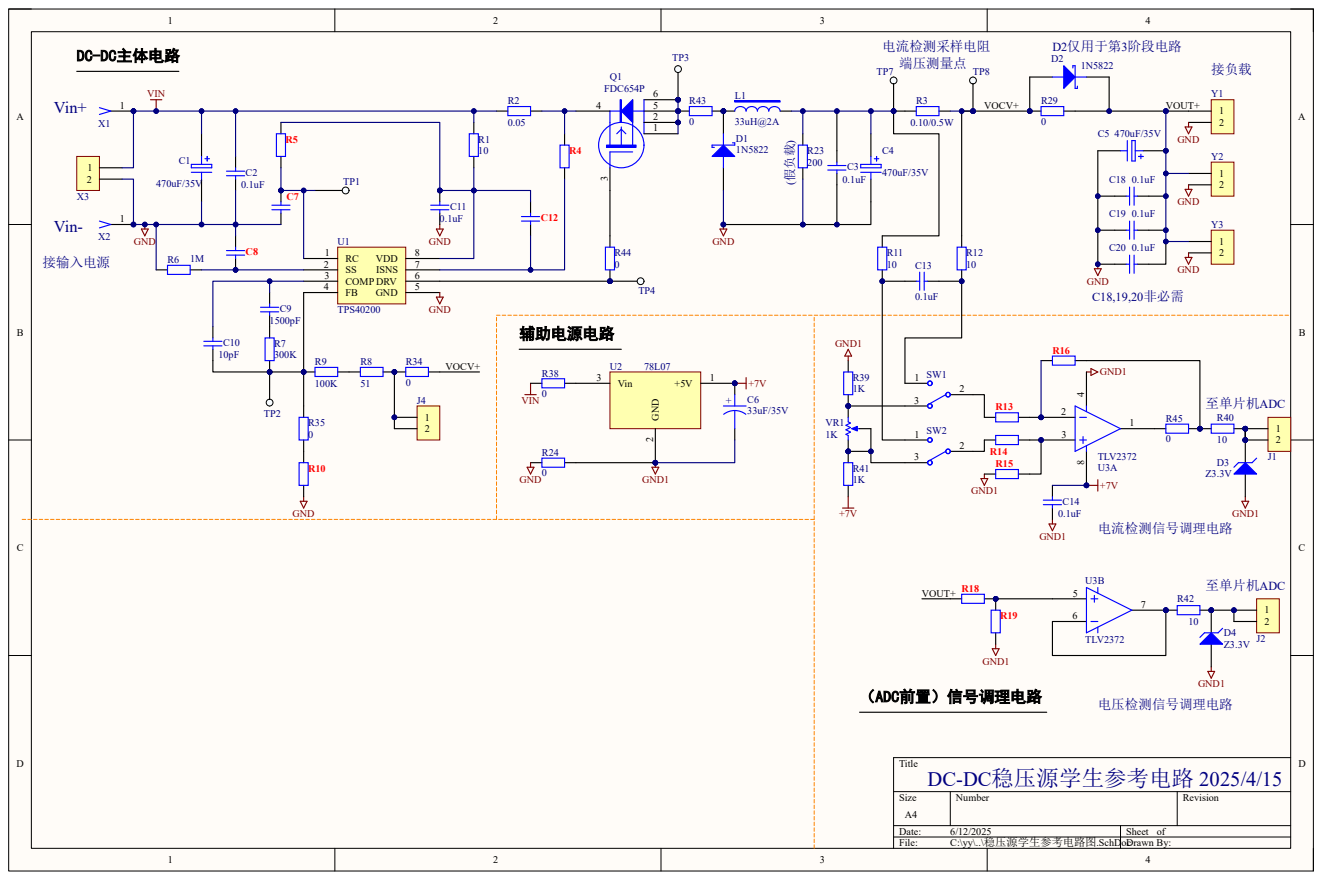
[picture p76: page 1]
