lin06121/DCDC_constant_current_power_supply/(list of files, drawings)

Other design files:
稳流源电路板_2026-10-23.epro
