lin06121/DCDC_constant_current_power_supply/(commit log)

2026-11-01 添加dac——datasheet
2026-11-01 电压通道标定：按实测修正 k=2.9917（CAL_V_MV_PER_MVQ=196063），显示真实输出电压
