lin06121/DCDC_constant_current_power_supply/(notices)

Notices in the files:
Pastcode/R Proj/driverlib/Frequency_Measure.c:
Copyright: 2021-2022, ÉÏº£½»Í¨´óÑ§µç×Ó¹¤³ÌÏµÊµÑé½ÌÑ§ÖÐÐÄ
Pastcode/R Proj/main.c:
Copyright: 2019-2020, ÉÏº£½»Í¨´óÑ§¹¤³ÌÊµ¼ùÓë¿Æ¼¼´´ÐÂII-A½ÌÑ§×é
Pastcode/R Proj/dac_demo.c:
Copyright: 2019-2021, ÉÏº£½»Í¨´óÑ§¹¤³ÌÊµ¼ùÓë¿Æ¼¼´´ÐÂIII-A½ÌÑ§×é
